quirogaluistomas/MDot_Caudal_Proyecto_2/Capturas de pantalla/Arquitectura1.JPG

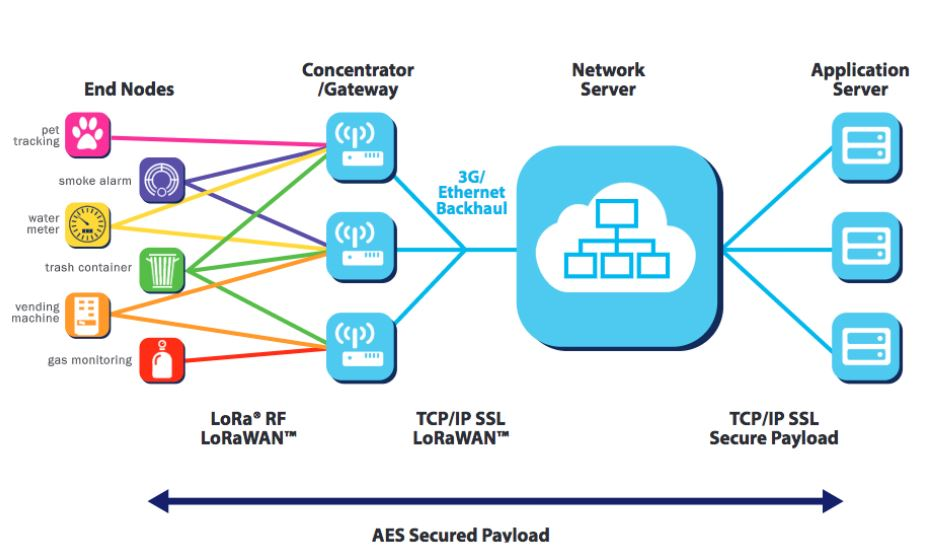
Capturas de pantalla/Arquitectura1.JPG
