quirogaluistomas/MDot_Caudal_Proyecto_2/Capturas de pantalla/Arquitectura LoRa.jpg

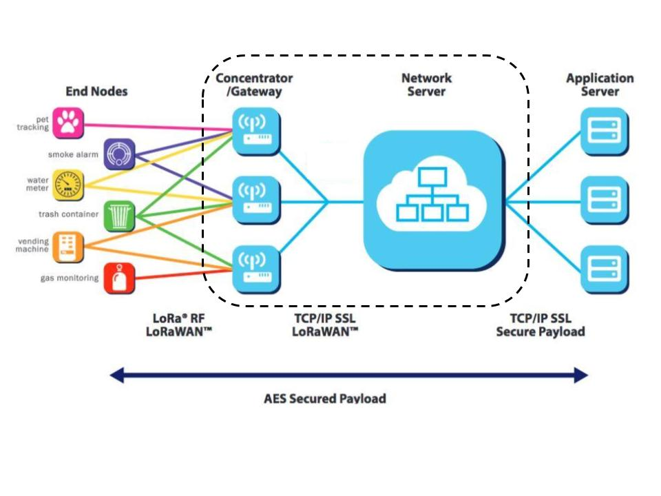
Capturas de pantalla/Arquitectura LoRa.jpg
