quirogaluistomas/MDot_Caudal_Proyecto_2/Capturas de pantalla/Arquitecura2.JPG

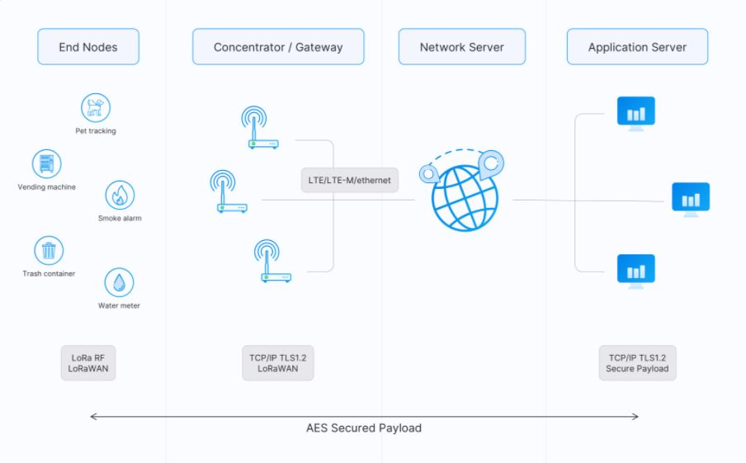
Capturas de pantalla/Arquitecura2.JPG
