quirogaluistomas/MDot_Caudal_Proyecto_2/Capturas de pantalla/Bloques3_GW.JPG

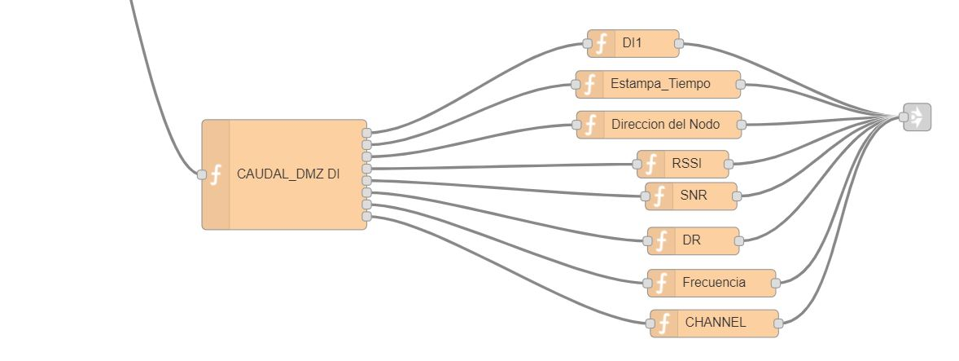
Capturas de pantalla/Bloques3_GW.JPG
