quirogaluistomas/MDot_Caudal_Proyecto_2/Capturas de pantalla/Broker2.JPG

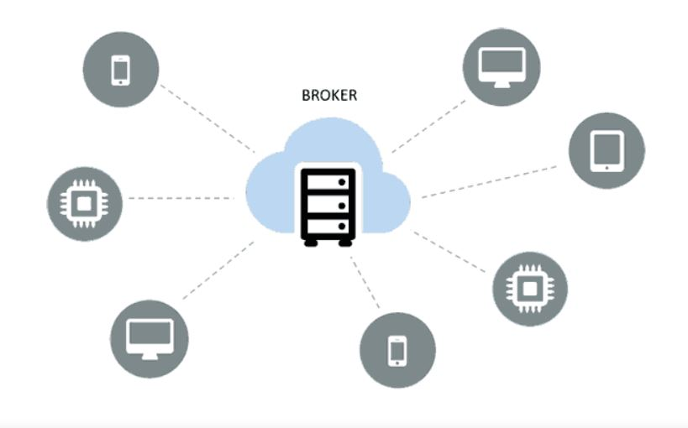
Capturas de pantalla/Broker2.JPG
