quirogaluistomas/MDot_Caudal_Proyecto_2/Capturas de pantalla/Broker.JPG

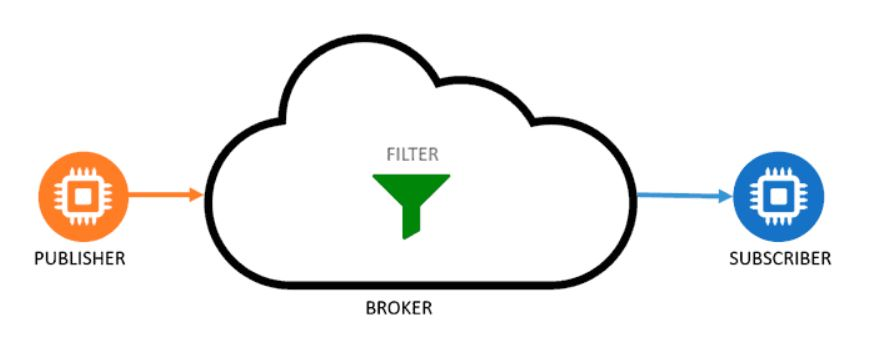
Capturas de pantalla/Broker.JPG
