quirogaluistomas/MDot_Caudal_Proyecto_2/Capturas de pantalla/Clase A.jpg

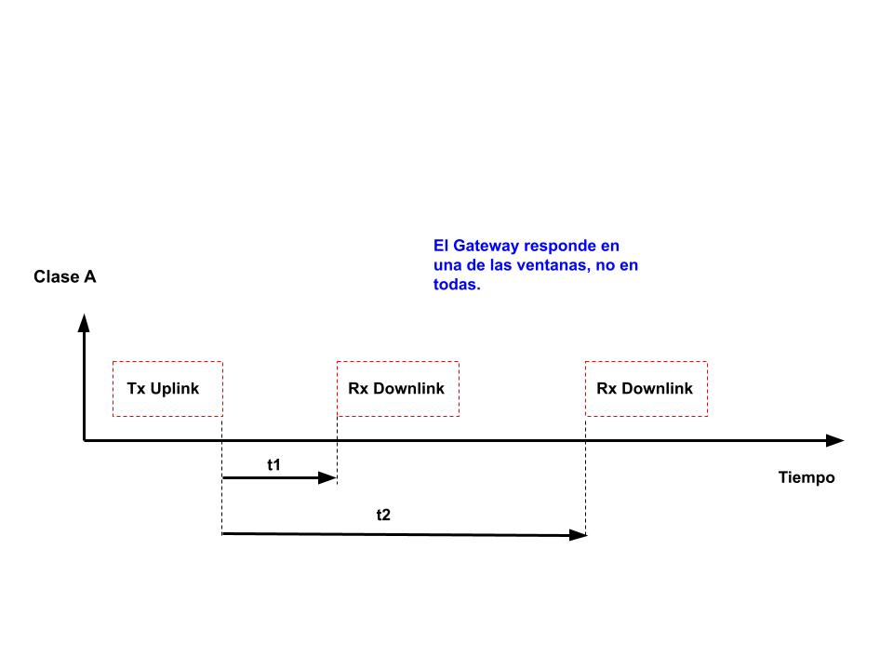
Capturas de pantalla/Clase A.jpg
