quirogaluistomas/MDot_Caudal_Proyecto_2/Capturas de pantalla/Clase B.jpg

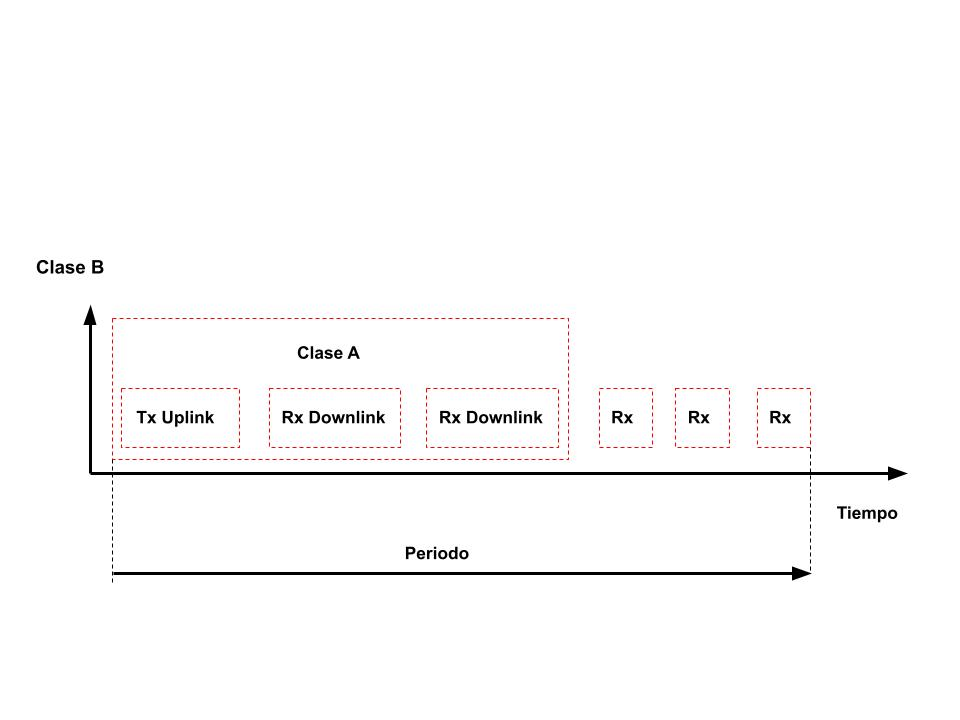
Capturas de pantalla/Clase B.jpg
