quirogaluistomas/MDot_Caudal_Proyecto_2/Capturas de pantalla/Clase C.jpg

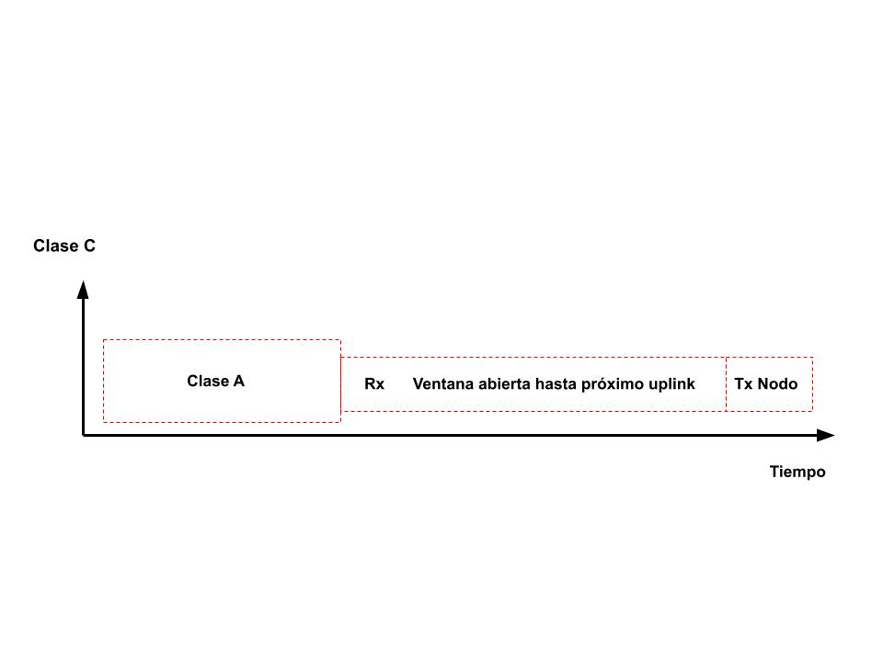
Capturas de pantalla/Clase C.jpg
