quirogaluistomas/MDot_Caudal_Proyecto_2/Capturas de pantalla/DatosCommLoRa.JPG

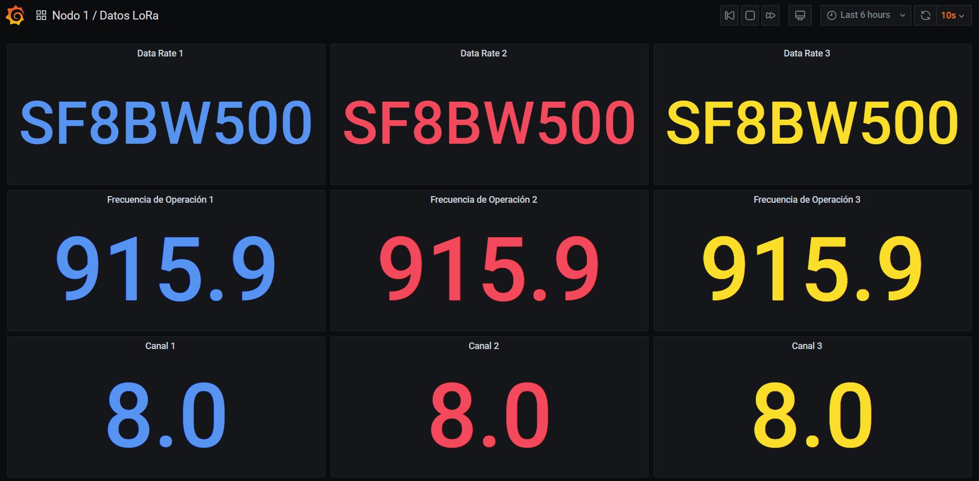
Capturas de pantalla/DatosCommLoRa.JPG
