quirogaluistomas/MDot_Caudal_Proyecto_2/Capturas de pantalla/DatosCommPaquete1_Inicio.JPG

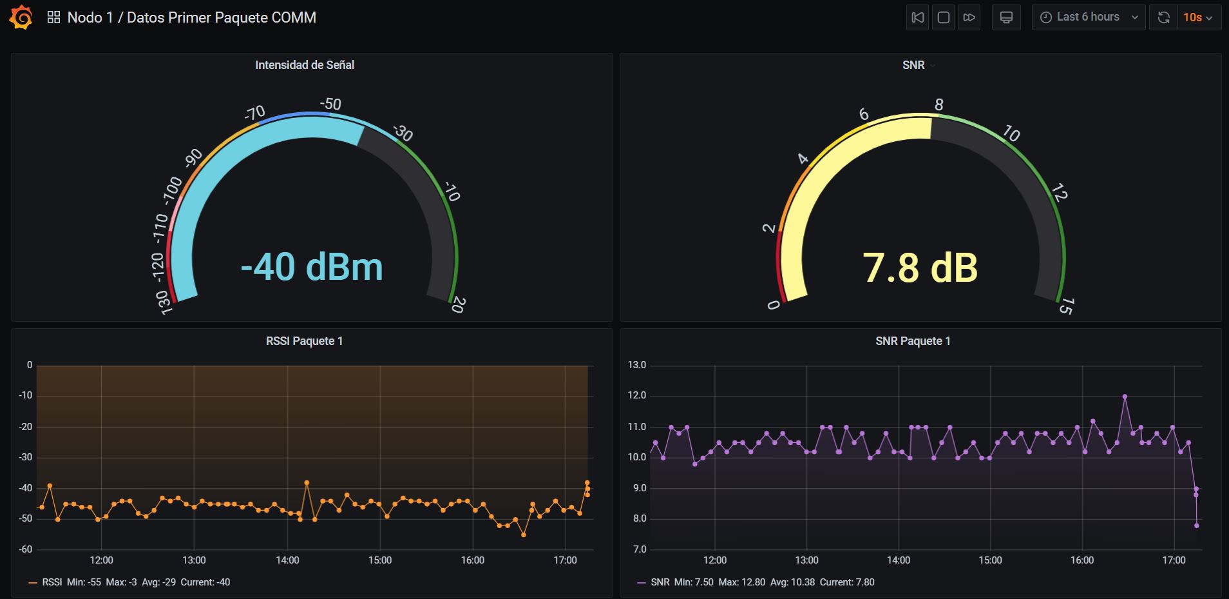
Capturas de pantalla/DatosCommPaquete1_Inicio.JPG
