quirogaluistomas/MDot_Caudal_Proyecto_2/Capturas de pantalla/DatosCommPaquete3.JPG

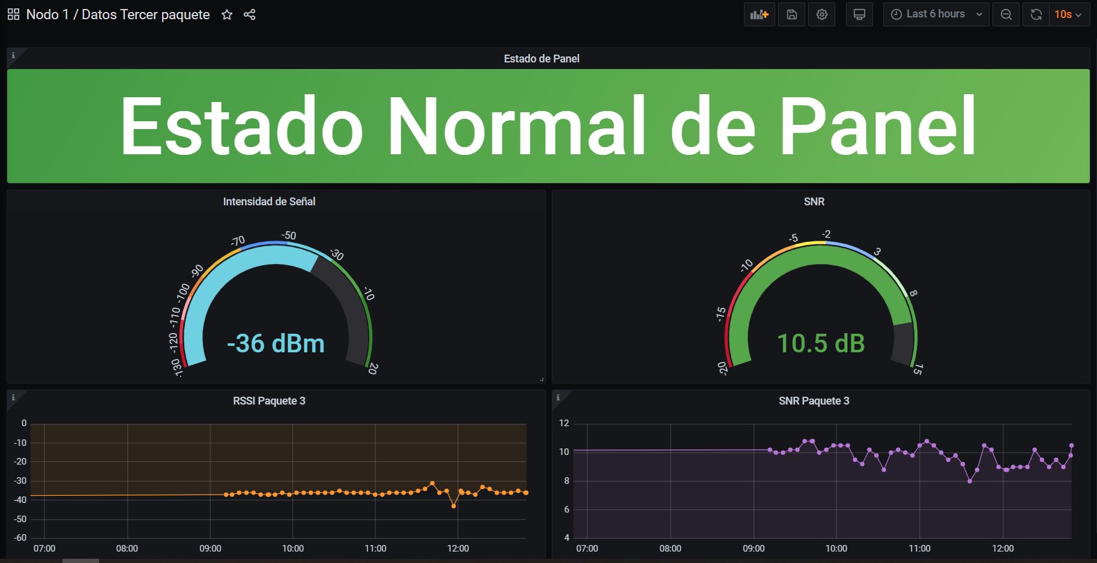
Capturas de pantalla/DatosCommPaquete3.JPG
