quirogaluistomas/MDot_Caudal_Proyecto_2/Capturas de pantalla/DatosCommPaquete3_inicio.JPG

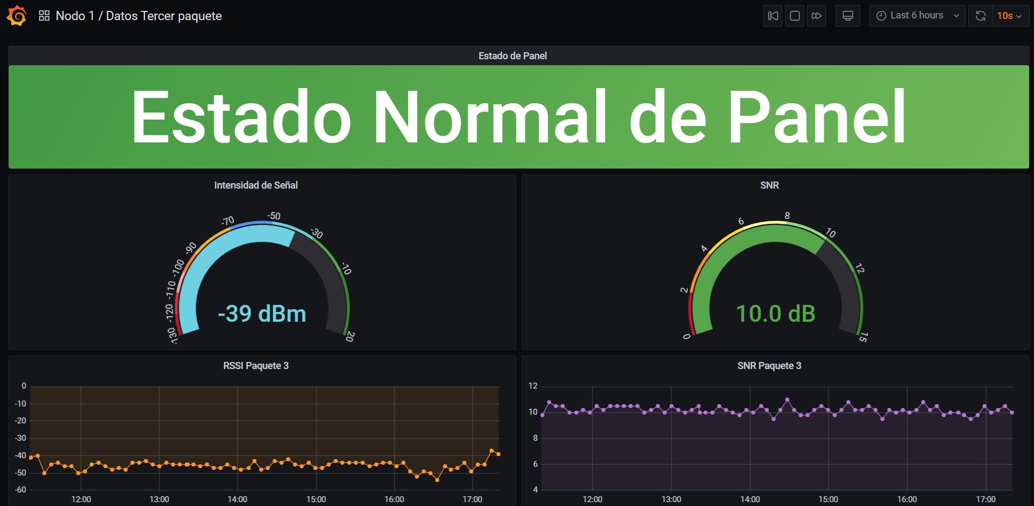
Capturas de pantalla/DatosCommPaquete3_inicio.JPG
