quirogaluistomas/MDot_Caudal_Proyecto_2/Capturas de pantalla/Downlink.JPG

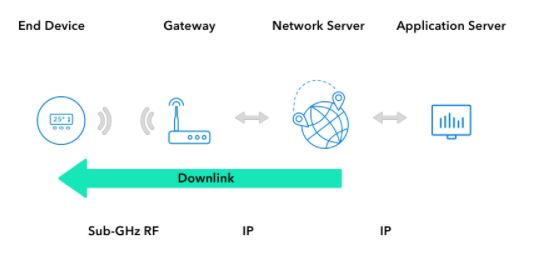
Capturas de pantalla/Downlink.JPG
