quirogaluistomas/MDot_Caudal_Proyecto_2/Capturas de pantalla/Esquema_Integrado.JPG

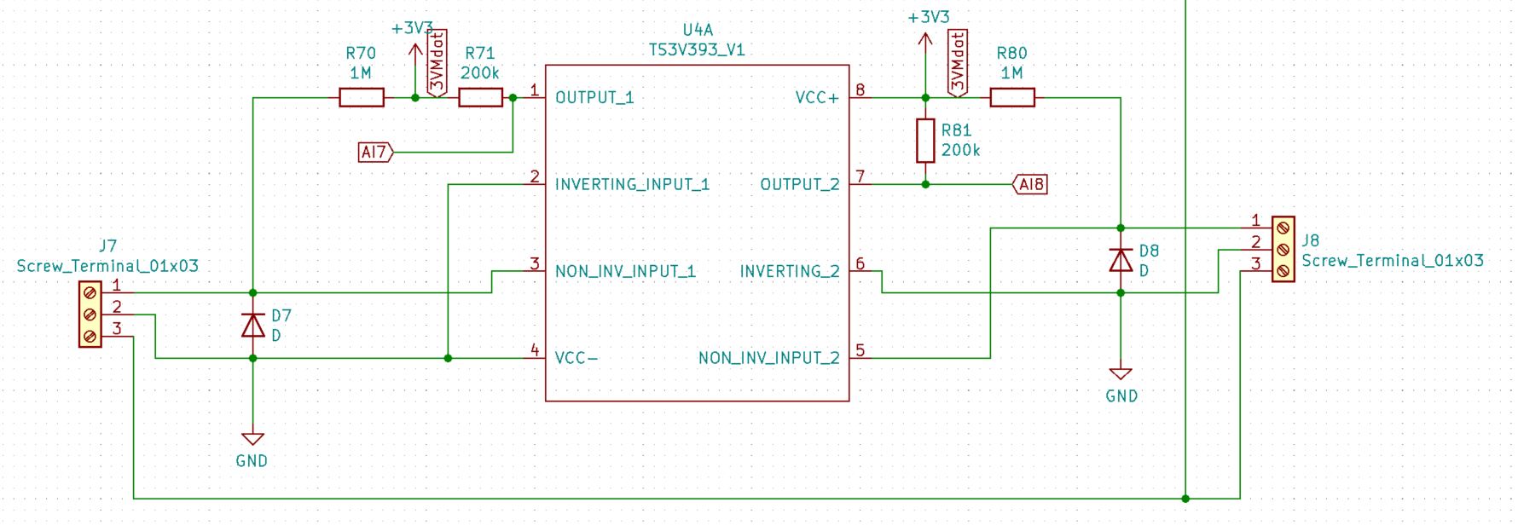
Capturas de pantalla/Esquema_Integrado.JPG
