quirogaluistomas/MDot_Caudal_Proyecto_2/Capturas de pantalla/Esquema_Integrado_OPAMP.JPG

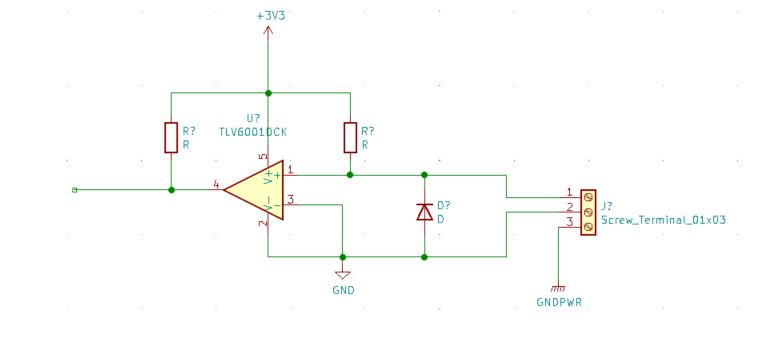
Capturas de pantalla/Esquema_Integrado_OPAMP.JPG
