quirogaluistomas/MDot_Caudal_Proyecto_2/Capturas de pantalla/Esquema_Micro.JPG

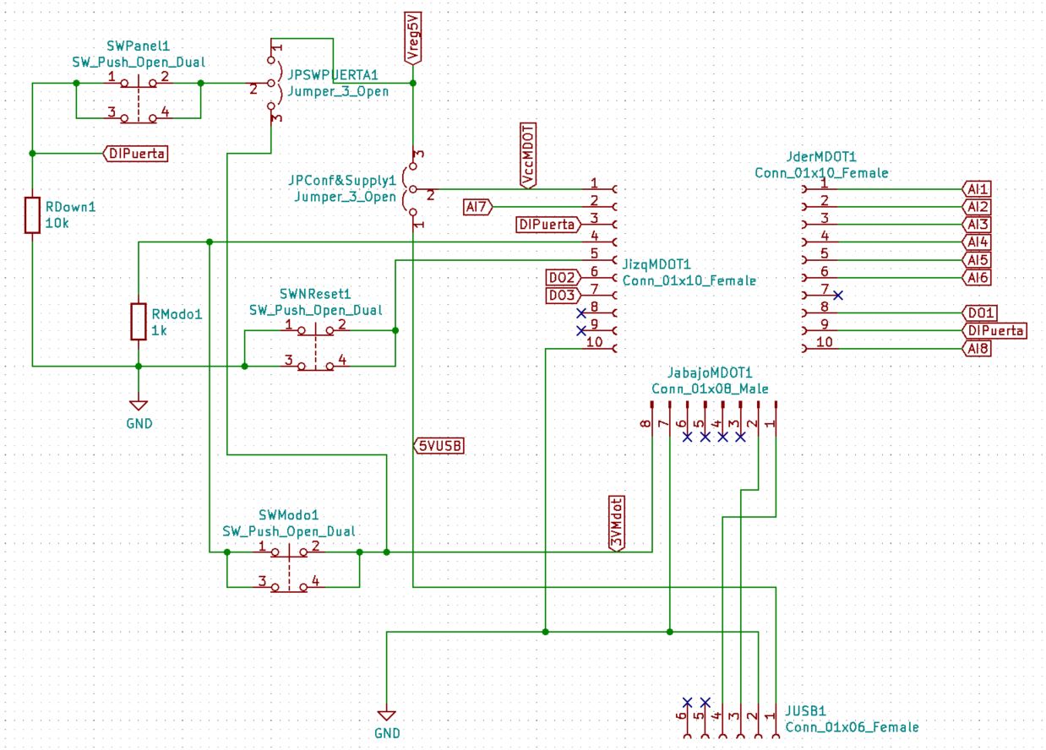
Capturas de pantalla/Esquema_Micro.JPG
