quirogaluistomas/MDot_Caudal_Proyecto_2/Capturas de pantalla/Esquematico_Panel.JPG

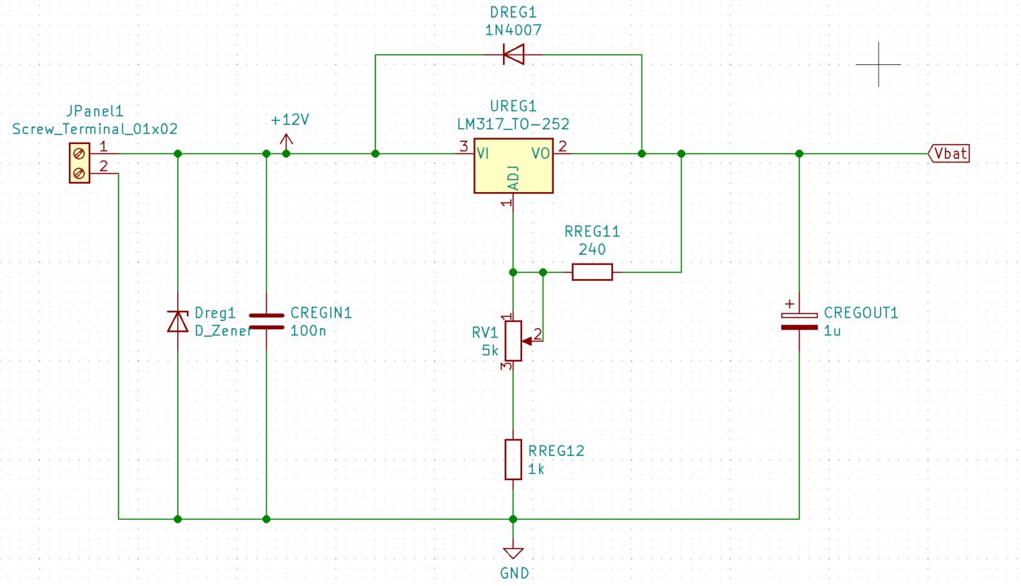
Capturas de pantalla/Esquematico_Panel.JPG
