quirogaluistomas/MDot_Caudal_Proyecto_2/Capturas de pantalla/LoRa Distancia.jpg

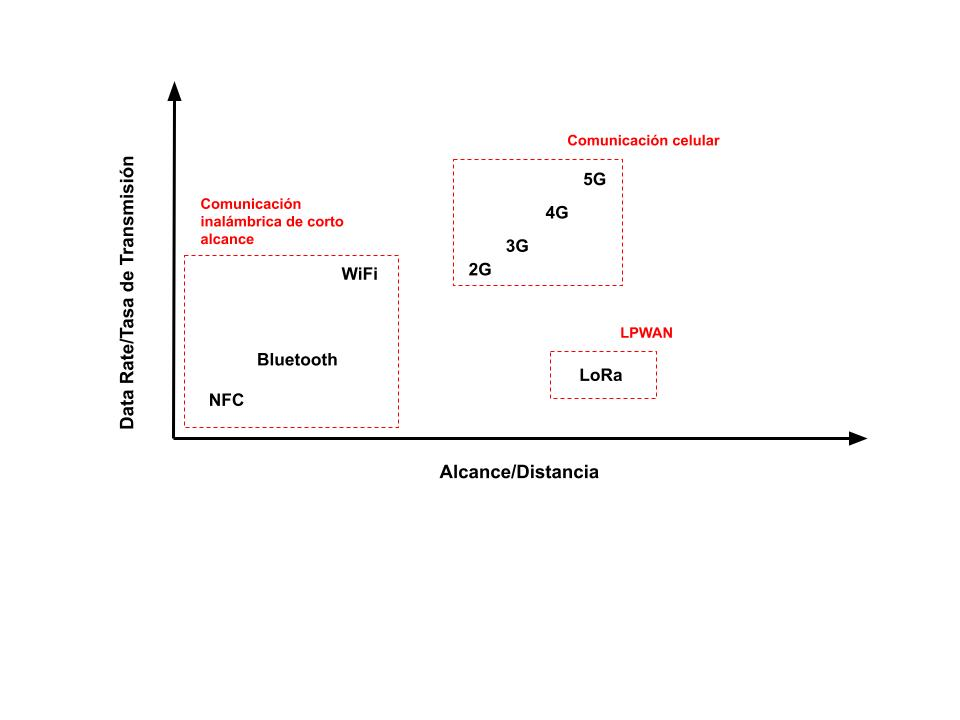
Capturas de pantalla/LoRa Distancia.jpg
