quirogaluistomas/MDot_Caudal_Proyecto_2/Capturas de pantalla/mdot.JPG

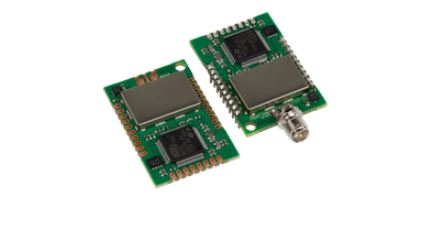
Capturas de pantalla/mdot.JPG
