quirogaluistomas/MDot_Caudal_Proyecto_2/Capturas de pantalla/mDot_pinout.JPG

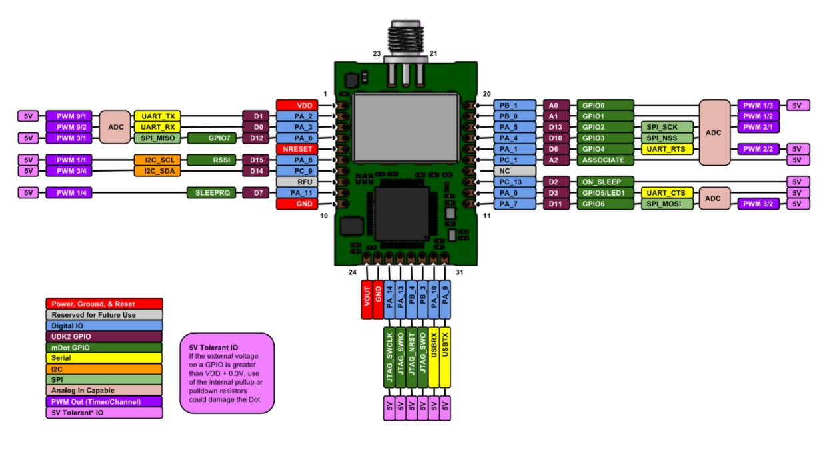
Capturas de pantalla/mDot_pinout.JPG
