quirogaluistomas/MDot_Caudal_Proyecto_2/Capturas de pantalla/NodeRED_GW_Config_Fun_Caudal1.JPG

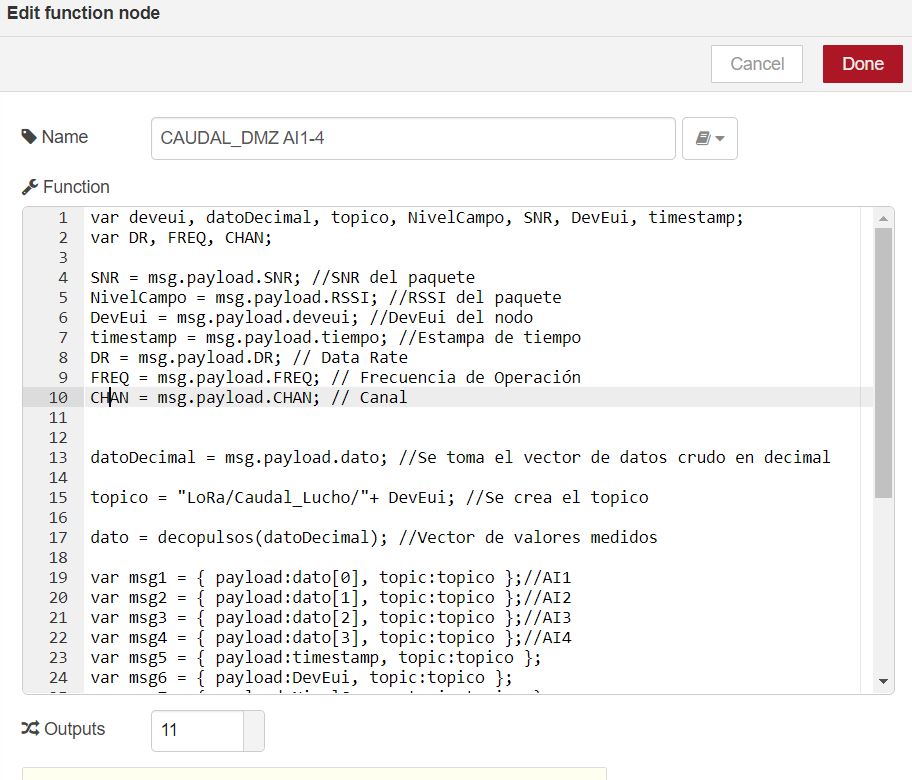
Capturas de pantalla/NodeRED_GW_Config_Fun_Caudal1.JPG
