quirogaluistomas/MDot_Caudal_Proyecto_2/Capturas de pantalla/NodeRED_GW_msg_datopublicado.JPG

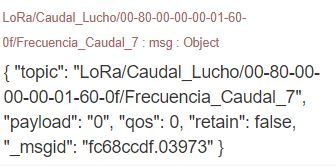
Capturas de pantalla/NodeRED_GW_msg_datopublicado.JPG
