quirogaluistomas/MDot_Caudal_Proyecto_2/Capturas de pantalla/NodeRED_Local_Bloques.JPG

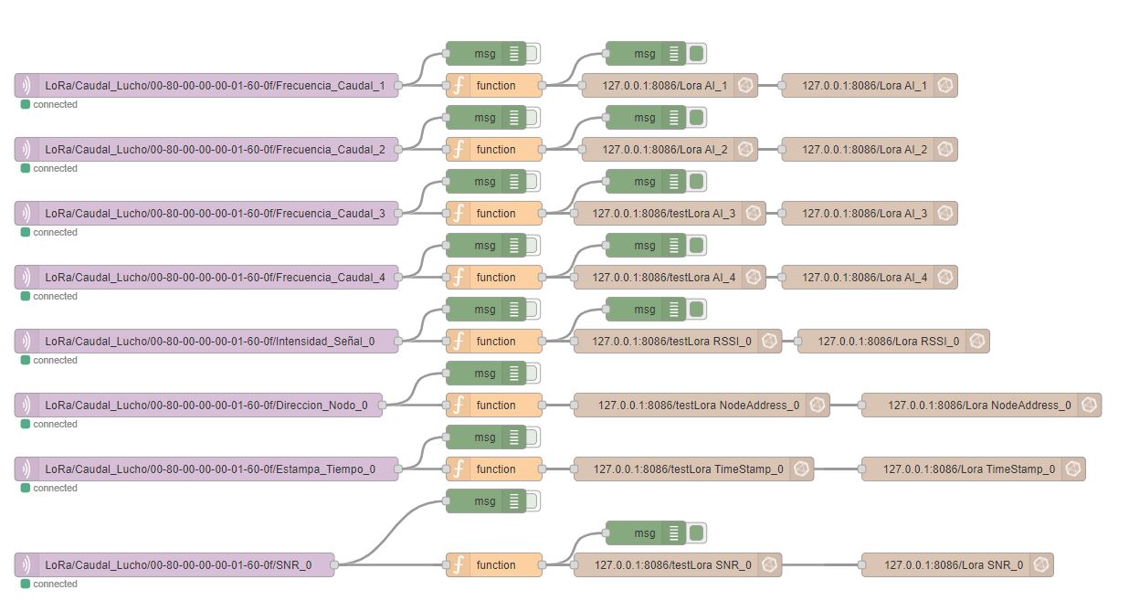
Capturas de pantalla/NodeRED_Local_Bloques.JPG
