quirogaluistomas/MDot_Caudal_Proyecto_2/Capturas de pantalla/NodeRED_Local_Config_MQTT.JPG

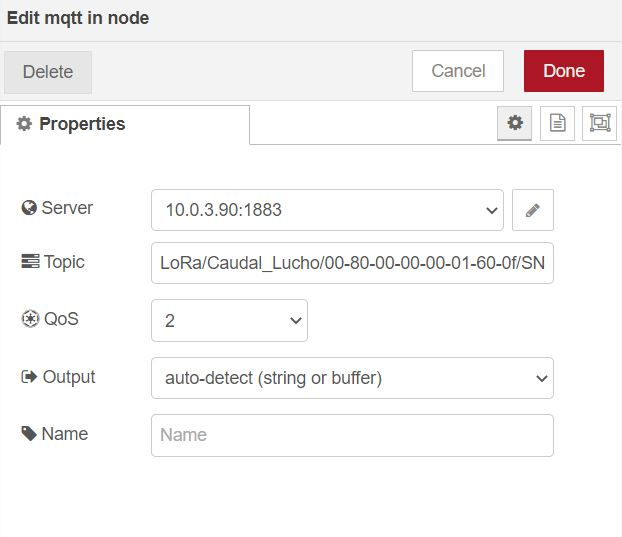
Capturas de pantalla/NodeRED_Local_Config_MQTT.JPG
