quirogaluistomas/MDot_Caudal_Proyecto_2/Capturas de pantalla/PCB_3D.JPG

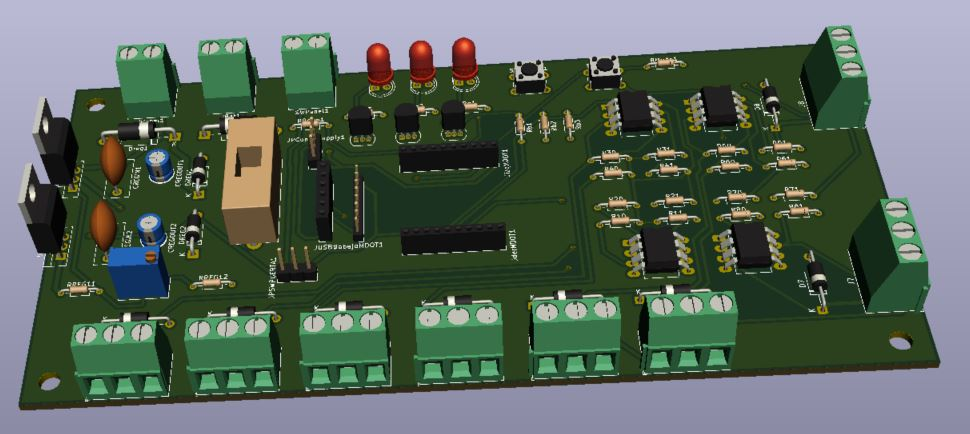
Capturas de pantalla/PCB_3D.JPG
