quirogaluistomas/MDot_Caudal_Proyecto_2/Capturas de pantalla/PCB_3D_1.JPG

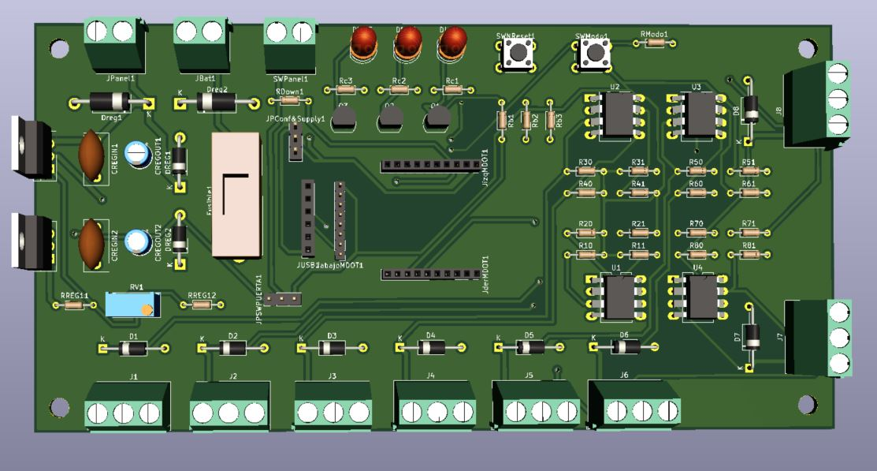
Capturas de pantalla/PCB_3D_1.JPG
