quirogaluistomas/MDot_Caudal_Proyecto_2/Capturas de pantalla/PCB_Back.JPG

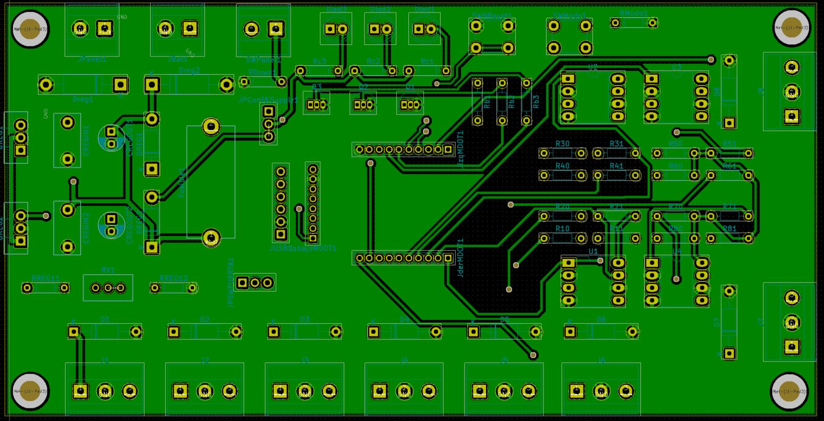
Capturas de pantalla/PCB_Back.JPG
