quirogaluistomas/MDot_Caudal_Proyecto_2/Capturas de pantalla/Sub_bandas_Canales.JPG

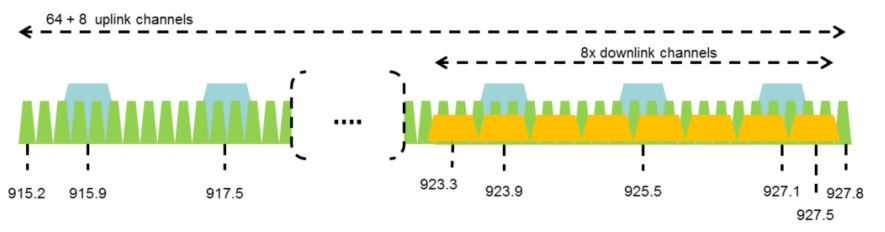
Capturas de pantalla/Sub_bandas_Canales.JPG
