quirogaluistomas/MDot_Caudal_Proyecto_2/Capturas de pantalla/Subbandas.JPG

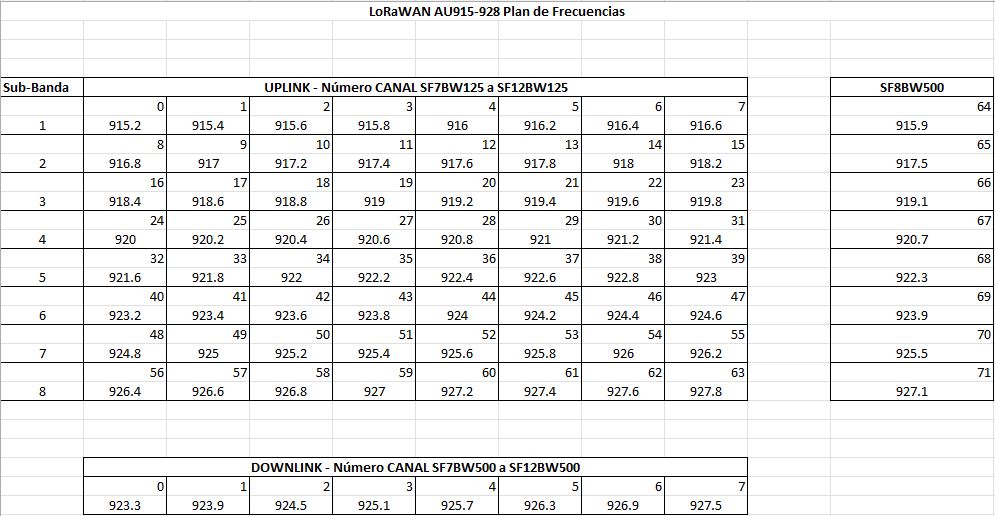
Capturas de pantalla/Subbandas.JPG
