quirogaluistomas/MDot_Caudal_Proyecto_2/Capturas de pantalla/Topics.JPG

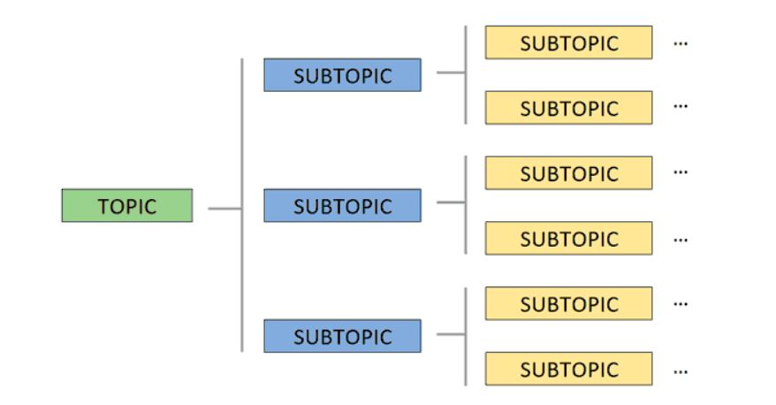
Capturas de pantalla/Topics.JPG
