quirogaluistomas/MDot_Caudal_Proyecto_2/Capturas de pantalla/Uplink.JPG

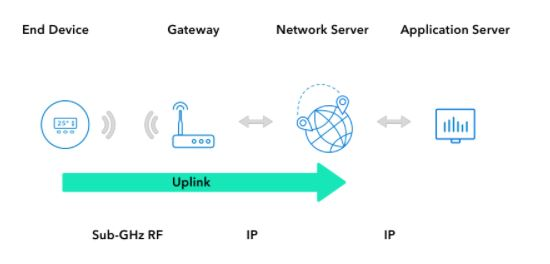
Capturas de pantalla/Uplink.JPG
