quirogaluistomas/MDot_Caudal_Proyecto_2/Listado Materiales Medidor Caudal LoRaWAN.xlsx

Sheet: Armado Placa
Materiales | Detalle | Cantidad | Proveedor | Costo Unitario (USD) | IVA | Costo parcial (USD) | Costo 8 ch (USD) | Estado
mDot | MTDOT-915-AU-X1P-SMA-1 | 1 | Multitech | 32 | 0.21 | 38.72 | 38.72
Resistencias R2 | Valor 1M 1% 1/4 W | 8 | SYC | 0.025 | 0.21 | 0.03025 | 0.242
Resistencias R3 | Valor 220K 1% 1/4 W | 8 | SYC | 0.025 | 0.21 | 0.03025 | 0.242
Resistencias R4 | Valor 220 1% 1/4 W | 4 | SYC | 0.025 | 0.21 | 0.03025 | 0.121 |  | Este reemplaza a la resistencia de 240 del 317.
Resistencias R5 | Valor 1K 1% 1/4 W | 2 | SYC | 0.025 | 0.21 | 0.03025 | 0.0605
Resistencia R6 | Valor 56k 1% 1/4 W | 3 | SYC | 0.025 | 0.21 | 0.03025 | 0.09075
Preset vertical | Valor 5K - 3296x | 1 | SYC | 0.5 | 0.21 | 0.605 | 0.605
Capacitor Cerámico Disco C1 | 100nF | 1 | Microelectronica | 0.03 | 0.21 | 0.0363 | 0.0363
Capacitor Multicapa C5 | 330nF | 1 | Microelectronica | 0.03 | 0.21 | 0.0363 | 0.0363 |  | Este reemplaza al de de 470nF ceramico.
Capacitor Electrolitico 35V C2 | 22uF | 1 | Microelectronica | 0.05 | 0.21 | 0.0605 | 0.0605
Capacitor Electrolitico 100V C4 | 0.47uF | 1 | Microelectronica | 0.04 | 0.21 | 0.0484 | 0.0484 |  | Este en realidad se reemplaza por el de 1uF.
Tira de Pines Hembra p/ USB x 10 | 2,54 mm pitch | 1 | Cicem SRL | 0.13 | 0.21 | 0.1573 | 0.1573
Tira de Pines Macho p/ JMP x 20 | 2,54 mm pitch | 1 | Cicem SRL | 0.13 | 0.21 | 0.1573 | 0.1573
Tira de Pines Macho p/ PCB x 10 | 2 mm pitch | 1 | Microelectronica | 0.474 | 0.21 | 0.57354 | 0.57354
Tira de Pines Hembra p/ PCB x 10 | 2 mm pitch | 2 | Microelectronica | 0.474 | 0.105 | 0.52377 | 1.04754
Comparador Ultra bajo consumo | TS3v3 | 4 | Cicem SRL | 0.84 | 0.105 | 0.9282 | 3.7128
Diodo | 1n4007 | 2 | SYC | 0.025 | 0.105 | 0.027625 | 0.05525
Diodo Schottky | SYC 1N5817 | 8 | SYC | 0.09 | 0.105 | 0.09945 | 0.7956
Diodo Zener 20V | 1N5357 20V 1W | 1 | Microelectronica | 0.121 | 0.105 | 0.133705 | 0.133705
Jumper largo con cola | pitch 2,54 mm | 2 | Microelectronica | 0.072 | 0.21 | 0.08712 | 0.17424
Push Button | Tact switch 4.3 mm | 2 | SYC | 0.08 | 0.105 | 0.0884 | 0.1768
Transistor | BC337 | 3 | SYC | 0.05 | 0.105 | 0.05525 | 0.16575
Led Amarillo | 5 mm | 1 | Microelectronica | 0.0894 | 0.105 | 0.098787 | 0.098787
Led Verde | 5 mm | 1 | Microelectronica | 0.0726 | 0.105 | 0.080223 | 0.080223
Led Rojo | 5 mm | 1 | Microelectronica | 0.0552 | 0.105 | 0.060996 | 0.060996
Regulador Voltaje | LM317T | 1 | SYC | 0.4 | 0.105 | 0.442 | 0.442
Regulador Voltaje 5V | LM2940 | 1 | SYC | 1.6 | 0.105 | 1.768 | 1.768
Disipador | para TO-220 | 1 | SYC | 1.1 | 0.21 | 1.331 | 1.331
Borneras 3 vias a 90 para PCB | Hembra | 8 | SYC | 0.57 | 0.105 | 0.62985 | 5.0388
Borneras 2 vias a 90 para PCB | Hembra | 3 | SYC | 0.35 | 0.105 | 0.38675 | 1.16025
Porta Fuse PCB | 20x5 mm | 1 | Microelectronica | 0.46 | 0.21 | 0.5566 | 0.5566
PCB | Impreso doble Faz con TH y Serigrafia | 1 | MEYER | 26.33 | 0.105 | 29.09465 | 29.09465
Total |  |  |  |  |  |  | 87.043881

Sheet: Armado Gabinete
Materiales | Detalle | Unidades | Proveedor | Costo Unitario (USD) | IVA | costo Parcial (USD) | Costo 1 Kit (USD) | Estado
Gabinete estanco Q Energy | bandeja 230X280X140 código 17232814 | 1 | Genrod | 26.85 | 0.21 | 32.4885 | 32.4885
Kit fijacion gabinete Q Energy |  | 1 | Genrod | 4.54 | 0.21 | 5.4934 | 5.4934
Bateria 12v Acido 7Ah |  | 1 | DGA Electronica | 11.6 | 0.21 | 14.036 | 14.036
Soporte Bateria | Soporte aluminio | 1 | Damez | 2 | 0.21 | 2.42 | 2.42
Panel Solar 12V 3W |  | 1 | Solartec | 7.5 | 0.21 | 9.075 | 9.075
Cable para panel | En metros x 0.25 | 1 | Indeca | 0.81 | 0.21 | 0.9801 | 0.9801
Soporte de Panel solar 1cm | Soporte aluminio | 1 | Damez | 2 | 0.21 | 2.42 | 2.42
Pig tail 50cm RP SMA macho invertido a 90° a N Hembra pasachapa + Cable RG58 | 1m | 1 | Indeca | 9.89 | 0.21 | 11.9669 | 11.9669
Antena 900 MHz 3 dbi Omni HG903UP-NF + Soporte | L-com 900 Mhz | 1 | L-Com | 87.26 | 0.21 | 105.5846 | 105.5846
Torres separadoras | Plásticas 15mm | 4 | Microelectronica | 0.638 | 0.21 | 0.77198 | 3.08792
Varios | Cables, termocontraibles, terminales | 1 | Damez | 2 | 0.21 | 2.42 | 2.42
Chapa Identificatoria | 8x4 | 1 | Damez | 1.2 | 0.21 | 1.452 | 1.452
Total |  |  |  |  |  |  | 191.42442
Tarea | Detalle | Horas |  | Precio Unitario USD | Precio Total USD
Horas Armado RTU y pruebas | Conforme a Ingeniería | 6 |  | 9.42 | 56.52

Sheet: Montaje
Materiales | Detalle | Unidades | Proveedor | Costo Unitario (USD) | IVA | costo Parcial (USD) | Costo 1 Kit (USD) | Estado
Prensacaño para caja rectangular | 1/2" NPT RECTO | 8 | Jumaled | 2.2 | 0.21 | 2.662 | 21.296
Prensacaño para caja de paso redonda | 3/4" NPT RECTO | 8 | Jumaled | 2.96 | 0.21 | 3.5816 | 28.6528
Caja paso rectangular a rosca | 1/2" | 8 | Jumaled | 3.61 | 0.21 | 4.3681 | 34.9448
Caja paso redonda de paso o empalme | 3/4" | 8 | Jumaled | 8.6 | 0.21 | 10.406 | 83.248
Broca SDS de anclaje de expansión p/anclaje en hormigón | 1/2" | 4 | Jumaled | 1.04 | 0.21 | 1.2584 | 5.0336
Bulon de acero | 1/2 x 3/4 | 4 | Jumaled | 0.23 | 0.21 | 0.2783 | 1.1132
Arandela plana | 3/4" | 4 | Jumaled | 0.32 | 0.21 | 0.3872 | 1.5488
Prensable recto | 1/2" | 16 | Jumaled | 0.35 | 0.21 | 0.4235 | 6.776
Cable mallado para señales | 2x0.5mm | 16 | Jumaled | 0.82 | 0.21 | 0.9922 | 15.8752
Tubo termocontraible | En metros | 2 | Jumaled | 0.38 | 0.21 | 0.4598 | 0.9196
Caño flexible corrugado | 3/4" | 10 | Jumaled | 3.45 | 0.21 | 4.1745 | 41.745
Caño flexible corrugado | 1/2" | 16 | Jumaled | 2.46 | 0.21 | 2.9766 | 47.6256
Tuerca luz 1/2" p/ caja redonda | NPT nodular | 1 | Jumaled | 0.34 | 0.21 | 0.4114 | 0.4114
Tuerca luz 3/4" p/ caja redonda | NPT nodular | 1 | Jumaled | 0.55 | 0.21 | 0.6655 | 0.6655
Caño hierro negro 3"x 2mts y tapa superior caño espesor 2,1mm | Kg | 5.75 | Casa Manito | 2.25 | 0.21 | 2.7225 | 15.654375
Electrodos 2.5mm Punta azul | Por kg | 1 | Dal Poggetto e Hijos | 4.56 | 0.21 | 5.5176 | 5.5176
Escuadra | 10x10x1/4" | 4 | HIMAQ | 1.41 | 0.21 | 1.7061 | 6.8244
Planchuela cuadrada de hierro para base | 30x30x1/4" | 1 | HIMAQ | 11.04 | 0.21 | 13.3584 | 13.3584
Varilla roscada galvanizada | 1/2" | 2 | Casa Manito | 3.84 | 0.21 | 4.6464 | 9.2928
Pintura Epoxi Negro | Por litro | 0.5 | Rex | 31.2 | 0.21 | 37.752 | 18.876
Diluyente Epoxi | Por litro | 0.5 | Rex | 18 | 0.21 | 21.78 | 10.89
Precintos metálicos | 500x25 | 16 |  | 0.71 | 0.21 | 0.8591 | 13.7456
Total |  |  |  |  |  |  | 370.269075
Tarea | Detalle | Horas |  | Precio Unitario USD | Precio Total USD
Horas de soldado y armado de mastil | Conforme a Ingeniería | 16 |  | 9.42 | 150.72

Sheet: Inv.Sueldos
INVERSION DE CAPITAL EN ESTUDIO Y DESARROLLO
 |  |  |  |  |  |  |  | Antes de la línea
MES | Encargado de Stock (1) | Equipo de Venta (1) | Equipo de Ingeniería/ Jefe de Proyecto (1) | Equipo de Desarrollo (1) | Técnico de Ensamblado (1) | COSTOS TOTALES
1 | 0.00 | 154.00 | 795.31 | 320.32 | 0.00 | 1269.63 | Marzo |  | Lucho | 7.28 | 1164
2 | 0.00 | 0.00 | 1406.99 | 800.80 | 0.00 | 2207.79 | Abril |  | Damian | 10.27 | 1643
3 | 0.00 | 231.00 | 1637.04 | 611.52 | 0.00 | 2479.56 | Mayo |  | Adrián | 7.7 | 1232
4 | 0.00 | 338.80 | 1129.70 | 232.96 | 0.00 | 1701.46 | Junio |  | Pablo | 5.99 | 958.4
5 | 0.00 | 431.20 | 1139.97 | 524.16 | 0.00 | 2095.33 | Julio |  | Marcelo | 9.42 | 1507.2
6 | 0.00 | 0.00 | 410.80 | 611.52 | 0.00 | 1022.32 | Agosto
7 | 0.00 | 0.00 | 400.53 | 844.48 | 0.00 | 1245.01 | Septiembre
8 | 47.92 | 63.14 | 872.95 | 946.40 | 0.00 | 1930.41 | Octubre
9 | 203.66 | 130.90 | 1386.45 | 669.76 | 0.00 | 2390.77 | Noviembre
10 | 323.46 | 154.00 | 1109.16 | 902.72 | 0.00 | 2489.34 | Diciembre
11 | 299.50 | 0.00 | 534.04 | 771.68 | 0.00 | 1605.22 | Enero
12 | 215.64 | 46.20 | 626.47 | 582.40 | 188.40 | 1659.11 | Febrero
13 | 383.36 | 30.80 | 759.98 | 626.08 | 226.08 | 2026.30 | Marzo
14 | 103.03 | 0.00 | 790.79 | 378.56 | 0.00 | 1272.38 | Abril
15 | 0.00 | 0.00 | 718.90 | 626.08 | 0.00 | 1344.98 | Mayo
16 | 0.00 | 0.00 | 718.90 | 728.00 | 0.00 | 1446.90 | Junio
17 | 0.00 | 0.00 | 534.04 | 305.76 | 0.00 | 839.80 | Julio
18 | 0.00 | 0.00 | 492.96 | 276.64 | 0.00 | 769.60 | Agosto
19 | 0.00 | 0.00 | 308.10 | 101.92 | 565.20 | 975.22 | Septiembre
20 |  |  |  |  |  | 0.00 | Octubre
21 | 1576.57 | 1580.04 | 15773.08 | 10861.76 | 979.68 | 30771.13
22
23
24
25 | PRIMER SEMESTRE
26 | 0.00 | 1155.00 | 6519.81 | 3101.28 | 0.00 | 10776.09
27
28 | SEGUNDO SEMESTRE
29 | 1090.18 | 394.24 | 4929.60 | 4717.44 | 188.40 | 11319.86
30
31 | TERCER SEMESTRE
32 | 486.39 | 30.80 | 4015.57 | 2941.12 | 226.08 | 7699.96
33
34 | CUARTO SEMESTRE
35 | 0.00 | 0.00 | 308.10 | 101.92 | 565.20 | 975.22
36
37
38
39
40
41
42
43
44
45
46
47
48
49
50
51
52
53
54
55
56
57
58
59
60
TOTAL

Sheet: Inv.Materiales
MATERIALES DE INVERSIÓN PARA DESARROLLO Y PRUEBAS
 |  |  | Antes de la línea
Para pruebas y repetibilidad
Placas | 346.846155 | Acá se compran materiales para 5 kits pero con PCB clásico
Gabinete | 957.1221 | Acá se compran materiales para 5 kits pero solo se arma 1
 |  |  |  | Lucho | 7.28
Total | 1303.968255 |  |  | Damian | 10.27
 |  |  |  | Adrián | 7.7
 |  |  |  | Pablo | 5.99
 |  |  |  | Marcelo | 9.42
Prototipo p/ prueba en sitio
Soldado de placa | 102.7 | Se sueldan y se prueban los componentes del prototipo
Construcción de Gabinete | 56.52 | Se construye solo 1 para prueba en sitio de clientes
 |  | Solo se envía gabinete, panel, antena y bateria. Del resto, lo que falta, se encargaron ellos. Se consideró minimo 15kg
Leandro PM | 82.16
Total | 241.38
Definitivos
Placas | 435.219405 | 5 Placas definitivas para repetibilidad y pruebas
Soldado de placas | 291.2 | Se sueldan las 5 placas para ensayos
Total | 726.419405

Sheet: Inv.Materiales p Stock
Inversión para stock de ventas
 |  |  | Luego de la línea
Placas p/ stock de ventas | 1305.658215 | 15 unidades
Placas para repetibilidad | 174.087762 | 2 unidades
Gabinete p/ stock de ventas | 2871.3663 | 15 unidades
Gabinete para repetibilidad | 382.84884 | 2 Unidades
Mástil p/ stock de ventas | 5554.036125 | 15 Unidades
Total p/stock | 10287.99724

Sheet: Consideraciones Costos
Concepto | Costo (USD) | Tiempo asignado a la tarea | Conceptos de Gastos/Costos
Flete de gabinetes + caños para montaje | 1.05 + 0.8% Seguro declarado | Por kg aunque también es función del volumen. Precio minimo 15kg | Gastos Generales
Embalaje (1 persona) | 5.14 | 1h/kit (Sueldo 60 Neto) | Gastos Generales
Vuelo a sitio para puesta en marcha (2 personas) | 257.14 |  | Gastos Generales
Dia viajado (2 personas) | 15.23 |  | MOD
Transporte a yacimiento para instalación Camioneta | 21.25 | (Medio tanque por sitio) 0.85usd x litro de gasoil | MOD
Logísitca de Sector Venta | 7.7 | 2h/total | MOI
Instalación y PM (2 personas) | 10.27 + 9.42 | 6h/sitio | MOD
Soporte de Oficina en PM | 7.28 | 1h/sitio | MOI
Construcción de Mastil | 9.42 | 16h x mastil | MOD
MOD = Mano de Obra Directa
MOI = Mano de Obra Indirecta

Sheet: Resumen
PROYECTO: | LORAWAN CAUDAL
Fecha: | 2021-12-17
PARÁMETROS GLOBALES
Precio de Venta: |  | 2000
 |  |  |  | Tasa mensual USD | 0.146%
 |  |  | VAN AJUST | TIR AJUST
UTILIDAD TEÓRICA: |  | 273687.72 | 269217.43 | 23.03%
PERIODO 6 MESES | UNIDADES A VENDER | INVERSION SUELDOS | INVERSION MATERIALES | COSTOS VARIABLES | VENTAS | IIBB | EGRESOS | IMP. GAN. | INGRESOS ACUMULADOS | EGRESOS ACUMULADOS | ING-EGRESOS | (1+i)^n | PERÍODOS | ING AJUST | EGR AJUST | ING ACUM AJ | EGR ACUM AJ | I-E AJUST
1 |  | 10776.09 | 1303.97 | 0.00 | 0.00 | 0.00 | 12080.06 |  | 0.00 | 12080.06 | -12080.06 | 1.00000 | 0 | 0.00 | 12080.06 | 0.00 | 12080.06 | -12080.06
2 |  | 11319.86 | 241.38 | 0.00 | 0.00 | 0.00 | 11561.24 |  | 0.00 | 23641.30 | -23641.30 | 1.00146 | 1 | 0.00 | 11544.41 | 0.00 | 23624.46 | -23624.46
3 |  | 7699.96 | 726.42 | 0.00 | 0.00 | 0.00 | 8426.38 |  | 0.00 | 32067.67 | -32067.67 | 1.00292 | 2 | 0.00 | 8401.86 | 0.00 | 32026.32 | -32026.32
4 |  | 975.22 | 10288.00 | 0.00 | 0.00 | 0.00 | 11263.22 |  | 0.00 | 43330.89 | -43330.89 | 1.00438 | 3 | 0.00 | 11214.10 | 0.00 | 43240.42 | -43240.42
5 | 40 |  |  | 35369.50 | 0.00 | 0.00 | 35369.50 |  | 0.00 | 78700.39 | -78700.39 | 1.00584 | 4 | 0.00 | 35163.97 | 0.00 | 78404.39 | -78404.39
6 | 50 |  |  | 44211.87 | 80000.00 | 2400.00 | 46611.87 |  | 80000.00 | 125312.25 | -45312.25 | 1.00731 | 5 | 79419.34 | 46273.55 | 79419.34 | 124677.94 | -45258.60
7 | 60 |  |  | 53054.24 | 100000.00 | 3000.00 | 56054.24 | 27066.86 | 180000.00 | 208433.36 | -28433.36 | 1.00878 | 6 | 99129.65 | 82397.66 | 178548.99 | 207075.60 | -28526.61
8 | 60 |  |  | 53054.24 | 120000.00 | 3600.00 | 56654.24 |  | 300000.00 | 265087.60 | 34912.40 | 1.01025 | 7 | 118782.39 | 56079.39 | 297331.38 | 263154.98 | 34176.40
9 | 60 |  |  | 53054.24 | 120000.00 | 3600.00 | 56654.24 | 44342.03 | 420000.00 | 366083.87 | 53916.13 | 1.01172 | 8 | 118609.46 | 99825.94 | 415940.84 | 362980.93 | 52959.91
10 | 50 |  |  | 44211.87 | 120000.00 | 3600.00 | 47811.87 |  | 540000.00 | 413895.74 | 126104.26 | 1.01320 | 9 | 118436.78 | 47189.03 | 534377.62 | 410169.96 | 124207.66
11 | 50 |  |  | 44211.87 | 100000.00 | 3000.00 | 47211.87 | 43741.69 | 640000.00 | 504849.30 | 135150.70 | 1.01468 | 10 | 98553.62 | 89638.03 | 632931.24 | 499807.99 | 133123.25
12 | 40 |  |  | 35369.50 | 100000.00 | 3000.00 | 38369.50 |  | 740000.00 | 543218.80 | 196781.20 | 1.01616 | 11 | 98410.14 | 37759.47 | 731341.38 | 537567.46 | 193773.92
13 | 40 |  |  | 35369.50 | 80000.00 | 2400.00 | 37769.50 | 36351.35 | 820000.00 | 617339.65 | 202660.35 | 1.01764 | 12 | 78613.50 | 72836.24 | 809954.88 | 610403.70 | 199551.18
14 | 30 |  |  | 26527.12 | 80000.00 | 2400.00 | 28927.12 |  | 900000.00 | 646266.77 | 253733.23 | 1.01912 | 13 | 78499.04 | 28384.39 | 888453.92 | 638788.09 | 249665.83
15 |  |  |  |  | 60000.00 | 1800.00 | 1800.00 | 38245.51 | 960000.00 | 686312.28 | 273687.72 | 1.02061 | 14 | 58788.57 | 39236.97 | 947242.49 | 678025.06 | 269217.43
16 |  |  |  |  | 0.00 | 0.00 | 0.00 |  | 960000.00 | 686312.28 | 273687.72 | 1.02209 | 15 | 0.00 | 0.00 | 947242.49 | 678025.06 | 269217.43
TOTALES | 480 | 30771.13 | 12559.76 | 424433.94 | 960000.00 | 28800.00 | 496564.83 | 189747.44
 | a8:96:75:6a:d6:7b
 | a8:a6:68:e3:11:f0

Sheet: Costo de Producto
Costo de producto sin servicio | PM = Puesta en Marcha
Costos MOD, Materiales y Gastos Generales de Producción | Cantidad | Tiempo asignado a la tarea por unidad [Hora] | Costo unidad | Costo Total
Materiales Placas | 1 |  | 87.043881 | 87.043881
Construcción Placas | 1 | 10 | 72.8 | 72.8
Materiales Gabinetes | 1 |  | 191.42442 | 191.42442
Construcción Gabinetes | 1 | 6 | 56.52 | 56.52
Materiales Mástil | 1 |  | 370.269075 | 370.269075
Construcción Mástil | 1 | 8 | 75.36 | 75.36
Embalaje | 1 | 1 | 5.14 | 5.14
Pintura | 1 | 2 | 10.28 | 10.28
Costos MOI para venta de producto
Logística de Sector Ventas | - | 2 | 15.4 | 15.4
 |  | Costo Unidad de Producto | 884.237376 | 884.237376

Sheet: Costo de Producto Con PM
Costo de unidad con servicio de PM. | PM = Puesta en Marcha
Costos MOD, Materiales y Gastos Generales de Producción y PM | Cantidad | Tiempo asignado a la tarea por unidad [Hora] | Costo unidad | Costo Total
Materiales Placas | 1 |  | 87.043881 | 87.043881
Construcción Placas | 1 | 10 | 72.8 | 72.8
Materiales Gabinetes | 1 |  | 191.42442 | 191.42442
Construcción Gabinetes | 1 | 6 | 56.52 | 56.52
Materiales para Montaje | 1 |  | 370.269075 | 370.269075
Construcción Mástil | 1 | 8 | 75.36 | 75.36
Embalaje | 1 | 1 | 5.14 | 5.14
Pintura | 1 | 2 | 10.28 | 10.28
Flete de gabinetes + caños para montaje | 1 | - | 606.538145 | 606.538145
Extra Dia Viajado (2 personas) | 4 | - | - | 60.92
Transporte a yacimiento para instalación Camioneta | 1 | - |  | 21.25
Vuelo a sitio para puesta en marcha (2 personas) | 2 | - | 257.14 | 514.28
Instalación y PM | 1 | 6 | 118.14 | 118.14
 |  | Total MOD | 2189.965521 | 2189.965521
Costos MOI para producción y PM | Cantidad | Tiempo asignado a la tarea por unidad [Hora] | Costo unidad | Costo Total
Soporte de oficina en PM | 1 | 1 | 7.28 | 7.28
Logística de Sector Ventas | - | 2 | 15.4 | 15.4
Gastos promedio de personal en Ciudad | 2 |  | 38.09 | 76.18
 |  | Total MOI |  | 98.86
 |  | Costo de 1 unidad |  | 2288.825521

Sheet: Ejemplo para 10 unidades
Costo de unidad con servicio de PM. | PM = Puesta en Marcha
Costos MOD, Materiales y Gastos Generales de Producción y PM | Cantidad | Tiempo asignado a la tarea por unidad [Hora] | Costo unidad | Costo Total
Materiales Placas | 10 |  | 87.043881 | 870.43881
Construcción Placas | 10 | 10 | 72.8 | 728
Materiales Gabinetes | 10 |  | 191.42442 | 1914.2442
Construcción Gabinetes | 10 | 6 | 56.52 | 565.2
Materiales Mástil | 10 |  | 370.269075 | 3702.69075
Construcción Mástil | 10 | 8 | 75.36 | 753.6
Embalaje | 10 | 1 | 5.14 | 51.4
Pintura | 10 | 2 | 10.28 | 102.8
Flete de gabinetes + caños para montaje | 10 | - | 606.538145 | 5923.63145
Extra Dia Viajado (2 personas) | 24 | - | - | 365.52
Transporte a yacimiento para instalación Camioneta | 10 | - |  | 212.5
Vuelo a sitio para puesta en marcha (2 personas) | 2 | - | 257.14 | 514.28
Instalación y PM | 10 | 6 | 118.14 | 1181.4
 |  | Total MOD | 1688.570521 | 16885.70521
Costos MOI para producción y PM | Cantidad | Tiempo asignado a la tarea por unidad [Hora] | Costo unidad | Costo Total
Soporte de oficina en PM | 10 | 1 | 7.28 | 72.8
Logística de Sector Ventas | - | 2 | 15.4 | 15.4
Gastos promedio de personal en Ciudad | 12 |  | 38.09 | 457.08
 |  | Total MOI | 54.528 | 545.28
 |  | Costo de 1 unidad |  | 17430.98521

Sheet: Impuestos
IMPUESTOS A LAS GANANCIAS
 | Año 1 | Año 2 | Año 3 | Año 4 | Año 5
INGRESOS | 180000.00 | 240000.00 | 220000.00 | 180000.00 | 140000.00
EGRESOS | 102666.11 | 113308.49 | 95023.74 | 76138.99 | 30727.12
I-E | 77333.89 | 126691.51 | 124976.26 | 103861.01 | 109272.88
Impuestos | 27066.86 | 44342.03 | 43741.69 | 36351.35 | 38245.51

Sheet: Otros Ingresos
OTROS INGRESOS
Por ejemplo inversiones del excedente del flujo de fondos
MES | Flujo de fondos | Saldo positivo | Inversión
1 | -12080.06 | 0.00 | 0.00
2 | -23641.30 | 0.00 | 0.00
3 | -32067.67 | 0.00 | 0.00
4 | -43330.89 | 0.00 | 0.00
5 | -78700.39 | 0.00 | 0.00
6 | -45312.25 | 0.00 | 0.00
7 | -28433.36 | 0.00 | 0.00
8 | 34912.40 | 34912.40 | 0.00
9 | 53916.13 | 53916.13 | 0.00
10 | 126104.26 | 126104.26 | 0.00
11 | 135150.70 | 135150.70 | 0.00
12 | 196781.20 | 196781.20 | 0.00
13 | 202660.35 | 202660.35 | 0.00
14 | 253733.23 | 253733.23 | 0.00
15 | #REF! | #REF! | 0.00
16 | #REF! | #REF! | 0.00
17 | #REF! | #REF! | 0.00
18 | #REF! | #REF! | 0.00
19 | #REF! | #REF! | 0.00
20 | #REF! | #REF! | #REF!
21 | #REF! | #REF! | #REF!
22 | #REF! | #REF! | #REF!
23 | #REF! | #REF! | #REF!
24 | #REF! | #REF! | #REF!
25 | #REF! | #REF! | #REF!
26 | #REF! | #REF! | #REF!
27 | #REF! | #REF! | #REF!
28 | #REF! | #REF! | #REF!
29 | #REF! | #REF! | #REF!
30 | #REF! | #REF! | #REF!
31 | #REF! | #REF! | #REF!
32 | #REF! | #REF! | #REF!
33 | #REF! | #REF! | #REF!
34 | #REF! | #REF! | #REF!
35 | #REF! | #REF! | #REF!
36 | #REF! | #REF! | #REF!
37 | #REF! | #REF! | #REF!
38 | #REF! | #REF! | #REF!
39 | #REF! | #REF! | #REF!
40 | #REF! | #REF! | #REF!
41 | #REF! | #REF! | #REF!
42 | #REF! | #REF! | #REF!
43 | #REF! | #REF! | #REF!
44 | #REF! | #REF! | #REF!
45 | #REF! | #REF! | #REF!
46 | #REF! | #REF! | #REF!
47 | #REF! | #REF! | #REF!
48 | #REF! | #REF! | #REF!
49 | #REF! | #REF! | #REF!
50 | #REF! | #REF! | #REF!
51 | #REF! | #REF! | #REF!
52 | #REF! | #REF! | #REF!
53 | #REF! | #REF! | #REF!
54 | #REF! | #REF! | #REF!
55 | #REF! | #REF! | #REF!
56 | #REF! | #REF! | #REF!
57 | #REF! | #REF! | #REF!
58 | #REF! | #REF! | #REF!
59 | 273687.72 | 273687.72 | #REF!
60 | 273687.72 | 273687.72 | 0.00

Sheet: Inversión Inicial
INVERSIÓN INICIAL
MES | GASTO1 | GASTO2 | GASTO3 | TOTAL GASTOS
1 |  |  |  | 0 | 2281.83 | Creo que no hay que poner nada en inversión inicial ya que como criterio lo consideré como costo fijo + variables
2 |  |  |  | 0 | 2281.83 | como criterio para poder decir cuánto invertir en todo
3 |  |  |  | 0 | 2281.83
4 |  |  |  | 0 | 2281.83
5 |  |  |  | 0 | 2281.83
6 |  |  |  | 0 | 2281.83
7 |  |  |  | 0 | 2817.83
8 |  |  |  | 0 | 2817.83
9 |  |  |  | 0 | 2817.83
10 |  |  |  | 0 | 2817.83
11 |  |  |  | 0 | 2817.83
12 |  |  |  | 0 | 2817.83
13 |  |  |  | 0 | 2817.83
14 |  |  |  | 0 | 2817.83
15 |  |  |  | 0 | 2817.83
16 |  |  |  | 0 | 2817.83
17 |  |  |  | 0 | 2817.83
18 |  |  |  | 0 | 2817.83
19 |  |  |  | 0
20 |  |  |  | 0
21 |  |  |  | 0
22 |  |  |  | 0
23 |  |  |  | 0
24 |  |  |  | 0
25 |  |  |  | 0
26 |  |  |  | 0
27 |  |  |  | 0
28 |  |  |  | 0
29 |  |  |  | 0
30 |  |  |  | 0
31 |  |  |  | 0
32 |  |  |  | 0
33 |  |  |  | 0
34 |  |  |  | 0
35 |  |  |  | 0
36 |  |  |  | 0
37 |  |  |  | 0
38 |  |  |  | 0
39 |  |  |  | 0
40 |  |  |  | 0
41 |  |  |  | 0
42 |  |  |  | 0
43 |  |  |  | 0
44 |  |  |  | 0
45 |  |  |  | 0
46 |  |  |  | 0
47 |  |  |  | 0
48 |  |  |  | 0
49 |  |  |  | 0
50 |  |  |  | 0
51 |  |  |  | 0
52 |  |  |  | 0
53 |  |  |  | 0
54 |  |  |  | 0
55 |  |  |  | 0
56 |  |  |  | 0
57 |  |  |  | 0
58 |  |  |  | 0
59 |  |  |  | 0
60 |  |  |  | 0
TOTAL |  |  |  | 0

Sheet: COSTOS FIJOS
COSTOS FIJOS
MES | Encargado de Stock (1) | Equipo de Venta (1) | Equipo de Ingeniería/ Jefe de Proyecto (1) | Equipo de Desarrollo (1) | Técnico de Ensamblado (1) | COSTOS TOTALES
1 | 0.00 | 154.00 | 795.31 | 320.32 | 0.00 | 1269.63 | Marzo |  | Lucho | 7.28 | 1164
2 | 0.00 | 0.00 | 1406.99 | 800.80 | 0.00 | 2207.79 | Abril |  | Damian | 10.27 | 1643
3 | 0.00 | 231.00 | 1637.04 | 611.52 | 0.00 | 2479.56 | Mayo |  | Adrián | 7.7 | 1232
4 | 0.00 | 338.80 | 1129.70 | 232.96 | 0.00 | 1701.46 | Junio |  | Pablo | 5.99 | 958.4
5 | 0.00 | 431.20 | 1139.97 | 524.16 | 0.00 | 2095.33 | Julio |  | Marcelo | 9.42 | 1507.2
6 | 0.00 | 0.00 | 410.80 | 611.52 | 0.00 | 1022.32
7 | 0.00 | 0.00 | 400.53 | 844.48 | 0.00 | 1245.01 | Septiembre
8 | 47.92 | 63.14 | 872.95 | 946.40 | 0.00 | 1930.41
9 | 203.66 | 130.90 | 1386.45 | 669.76 | 0.00 | 2390.77 | Noviembre
10 | 323.46 | 154.00 | 1109.16 | 902.72 | 0.00 | 2489.34 | Diciembre
11 | 299.50 | 0.00 | 534.04 | 771.68 | 0.00 | 1605.22 | Enero
12 | 215.64 | 46.20 | 626.47 | 582.40 | 188.40 | 1659.11 | Febrero
13 | 383.36 | 30.80 | 759.98 | 626.08 | 226.08 | 2026.30 | Marzo | Acá se pueden agregar horas si no da
14 | 103.03 | 0.00 | 790.79 | 378.56 | 0.00 | 1272.38
15 | 0.00 | 0.00 | 718.90 | 626.08 | 0.00 | 1344.98
16 | 0.00 | 0.00 | 718.90 | 728.00 | 0.00 | 1446.90 | Junio
17 | 0.00 | 0.00 | 534.04 | 305.76 | 0.00 | 839.80
18 | 0.00 | 0.00 | 492.96 | 276.64 | 0.00 | 769.60
19 | 0.00 | 0.00 | 308.10 | 101.92 | 565.20 | 975.22 | Septiembre
20 |  |  |  |  |  | 0.00 | Octubre
21 | 1576.57 | 1580.04 | 15773.08 | 10861.76 | 979.68 | 30771.13
22 |  |  |  |  |  | 0.00
23 |  |  |  |  |  | 0.00
24 |  |  |  |  |  | 0.00
25 |  |  |  |  |  | 0.00
26 |  |  |  |  |  | 0.00
27 |  |  |  |  |  | 0.00
28 |  |  |  |  |  | 0.00
29 |  |  |  |  |  | 0.00
30 |  |  |  |  |  | 0.00
31 |  |  |  |  |  | 0.00
32 |  |  |  |  |  | 0.00
33 |  |  |  |  |  | 0.00
34 |  |  |  |  |  | 0.00
35 |  |  |  |  |  | 0.00
36 |  |  |  |  |  | 0.00
37 |  |  |  |  |  | 0.00
38 |  |  |  |  |  | 0.00
39 |  |  |  |  |  | 0.00
40 |  |  |  |  |  | 0.00
41 |  |  |  |  |  | 0.00
42 |  |  |  |  |  | 0.00
43 |  |  |  |  |  | 0.00
44 |  |  |  |  |  | 0.00
45 |  |  |  |  |  | 0.00
46 |  |  |  |  |  | 0.00
47 |  |  |  |  |  | 0.00
48 |  |  |  |  |  | 0.00
49 |  |  |  |  |  | 0.00
50 |  |  |  |  |  | 0.00
51 |  |  |  |  |  | 0.00
52 |  |  |  |  |  | 0.00
53 |  |  |  |  |  | 0.00
54 |  |  |  |  |  | 0.00
55 |  |  |  |  |  | 0.00
56 |  |  |  |  |  | 0.00
57 |  |  |  |  |  | 0.00
58 |  |  |  |  |  | 0.00
59 |  |  |  |  |  | 0.00
60 |  |  |  |  |  | 0.00
TOTAL |  |  |  |  |  | 61542.25
MATERIALES DE INVERSIÓN PARA DESARROLLO Y PRUEBAS
Prototipo

Sheet: COSTOS VARIABLES
COSTOS VARIABLES
MES | Armado De Placa | Armado De Gabinete | Ensamblado y Montaje | COSTO UNITARIO TOTAL | UNIDADES | COSTO TOTAL
1 | 87.14 | 181.28 | 60.00 | 327.41 | 0 | 0.00 | Acá hay que tener cuidado porque si bien yo consideré monto de inversión por una cantidad X
2 | 87.14 | 181.28 | 60.00 | 327.41 | 0 | 0.00 | de nodos en realidad no se producieron con lo cual no es un costo actual..eso hay que verlo
3 | 87.14 | 181.28 | 60.00 | 327.41 | 0 | 0.00 | saber si es necesario simular que hay una cantidad X de nodos o simplemente no considerarlos y considerar solamente el total en inversion en la hoja de resumen
4 | 87.14 | 181.28 | 60.00 | 327.41 | 0 | 0.00
5 | 87.14 | 181.28 | 60.00 | 327.41 | 0 | 0.00
6 | 87.14 | 181.28 | 60.00 | 327.41 | 10 | 3274.10
7 | 87.14 | 181.28 | 60.00 | 327.41 | 0 | 0.00
8 | 87.14 | 181.28 | 60.00 | 327.41 | 0 | 0.00
9 | 87.14 | 181.28 | 60.00 | 327.41 | 0 | 0.00
10 | 87.14 | 181.28 | 60.00 | 327.41 | 0 | 0.00
11 | 87.14 | 181.28 | 60.00 | 327.41 | 0 | 0.00
12 | 87.14 | 181.28 | 60.00 | 327.41 | 20 | 6548.20
13 | 87.14 | 181.28 | 60.00 | 327.41 | 0 | 0.00
14 | 87.14 | 181.28 | 60.00 | 327.41 | 0 | 0.00
15 | 87.14 | 181.28 | 60.00 | 327.41 | 0 | 0.00
16 | 87.14 | 181.28 | 60.00 | 327.41 | 0 | 0.00
17 | 87.14 | 181.28 | 60.00 | 327.41 | 0 | 0.00
18 | 87.14 | 181.28 | 60.00 | 327.41 | 20 | 6548.20
19 | 87.14 | 181.28 | 60.00 | 327.41 | 0 | 0.00
20 | 87.14 | 181.28 | 60.00 | 327.41 | 0 | 0.00
21 | 87.14 | 181.28 | 60.00 | 327.41 | 0 | 0.00
22 | 87.14 | 181.28 | 60.00 | 327.41 | 0 | 0.00
23 | 87.14 | 181.28 | 60.00 | 327.41 | 0 | 0.00
24 | 87.14 | 181.28 | 60.00 | 327.41 | 20 | 6548.20
25 | 87.14 | 181.28 | 60.00 | 327.41 | 0 | 0.00
26 | 87.14 | 181.28 | 60.00 | 327.41 | 0 | 0.00
27 | 87.14 | 181.28 | 60.00 | 327.41 | 0 | 0.00
28 | 87.14 | 181.28 | 60.00 | 327.41 | 0 | 0.00
29 | 87.14 | 181.28 | 60.00 | 327.41 | 0 | 0.00
30 | 87.14 | 181.28 | 60.00 | 327.41 | 30 | 9822.30
31 | 87.14 | 181.28 | 60.00 | 327.41 | 0 | 0.00
32 | 87.14 | 181.28 | 60.00 | 327.41 | 0 | 0.00
33 | 87.14 | 181.28 | 60.00 | 327.41 | 0 | 0.00
34 | 87.14 | 181.28 | 60.00 | 327.41 | 0 | 0.00
35 | 87.14 | 181.28 | 60.00 | 327.41 | 0 | 0.00
36 | 87.14 | 181.28 | 60.00 | 327.41 | 20 | 6548.20
37 | 87.14 | 181.28 | 60.00 | 327.41 | 0 | 0.00
38 | 87.14 | 181.28 | 60.00 | 327.41 | 0 | 0.00
39 | 87.14 | 181.28 | 60.00 | 327.41 | 0 | 0.00
40 | 87.14 | 181.28 | 60.00 | 327.41 | 0 | 0.00
41 | 87.14 | 181.28 | 60.00 | 327.41 | 0 | 0.00
42 | 87.14 | 181.28 | 60.00 | 327.41 | 20 | 6548.20
43 | 87.14 | 181.28 | 60.00 | 327.41 | 0 | 0.00
44 | 87.14 | 181.28 | 60.00 | 327.41 | 0 | 0.00
45 | 87.14 | 181.28 | 60.00 | 327.41 | 0 | 0.00
46 | 87.14 | 181.28 | 60.00 | 327.41 | 0 | 0.00
47 | 87.14 | 181.28 | 60.00 | 327.41 | 0 | 0.00
48 | 87.14 | 181.28 | 60.00 | 327.41 | 10 | 3274.10
49 | 87.14 | 181.28 | 60.00 | 327.41 | 0 | 0.00
50 | 87.14 | 181.28 | 60.00 | 327.41 | 0 | 0.00
51 | 87.14 | 181.28 | 60.00 | 327.41 | 0 | 0.00
52 | 87.14 | 181.28 | 60.00 | 327.41 | 0 | 0.00
53 | 87.14 | 181.28 | 60.00 | 327.41 | 0 | 0.00
54 | 87.14 | 181.28 | 60.00 | 327.41 | 0 | 0.00
55 | 87.14 | 181.28 | 60.00 | 327.41 | 0 | 0.00
56 | 87.14 | 181.28 | 60.00 | 327.41 | 0 | 0.00
57 | 87.14 | 181.28 | 60.00 | 327.41 | 0 | 0.00
58 | 87.14 | 181.28 | 60.00 | 327.41 | 0 | 0.00
59 | 87.14 | 181.28 | 60.00 | 327.41 | 0 | 0.00
60 | 87.14 | 181.28 | 60.00 | 327.41 | 0 | 0.00
TOTAL |  |  |  |  |  | 49111.50

Sheet: Auxiliar
GRAFICO
 |  |  |  |  | Tasa | 0.15% | $993226.56
MES | INGRESOS ACUMULADOS | EGRESOS ACUMULADOS | ING-EGRESOS | I-E AJUSTADO | PERIODOS | FLUJO NORMAL
1 | 0.00 | 0.00 | -12080.06 | -12080.06 | 1 | -12080.06
2 | 0.00 | 0.00 | -23641.30 | -23624.46 | 2 | -23641.30
3 | 0.00 | 0.00 | -32067.67 | -32026.32 | 3 | -32067.67
4 | 0.00 | 0.00 | -43330.89 | -43240.42 | 4 | -43330.89
5 | 0.00 | 0.00 | -78700.39 | -78404.39 | 5 | -78700.39
6 | 80000.00 | -125312.25 | -45312.25 | -45258.60 | 6 | -45312.25
7 | 180000.00 | -208433.36 | -28433.36 | -28526.61 | 7 | -28433.36
8 | 300000.00 | -265087.60 | 34912.40 | 34176.40 | 8 | 34912.40
9 | 420000.00 | -366083.87 | 53916.13 | 52959.91 | 9 | 53916.13
10 | 540000.00 | -413895.74 | 126104.26 | 124207.66 | 10 | 126104.26
11 | 640000.00 | -504849.30 | 135150.70 | 133123.25 | 11 | 135150.70
12 | 740000.00 | -543218.80 | 196781.20 | 193773.92 | 12 | 196781.20
13 | 820000.00 | -617339.65 | 202660.35 | 199551.18 | 13 | 202660.35
14 | 900000.00 | -646266.77 | 253733.23 | 249665.83 | 14 | 253733.23
15 | 960000.00 | -686312.28 | 273687.72 | 269217.43 | 15 | 273687.72
16
17
18
19
20
21
22
23
24
25
26
27
28
29
30
31
32
33
34
35
36
37
38
39
40
41
42
43
44
45
46
47
48
49
50
51
52
53
54
55
56
57
58
59 | 960000.00 | -686312.28 | 273687.72 | 269217.43 | 59 | 273687.72
60 | 960000.00 | -686312.28 | 273687.72 | 269217.43 | 60 | 273687.72

Sheet: Consumo
 | Sleep [mA] | Calculo Logica [mA] | Tx [mA] | Rx [mA] | Tiempo Calculo[Seg] | Tiempo Tx [Seg] | Tiempo RX[Seg] | Periodo transmision [Seg] | Periodo de Tx y Rx de paq[Seg] | Sleep [Seg] | ConsumoEspera[mA] | TiempoEspera [Seg]
Regulador 5V (LM2940-5) | 7.2 | 33.94 | 130.91 | 20.61 | 7 | 0.096 | 0.084 | 3600 | 3.28 | 3546.48 | 10 | 3.1
mDot | 0.05 | 33.94 | 130.91
Comparadores TS3V393 x 2 | 0.02 | 0.02 | 0.02
Comparadores TS3V393 x 4 | 0.04 | 0.04 | 0.04
Comparadores TS3V393 x 6 | 0.06 | 0.06 | 0.06
Comparadores TS3V393 x 8 | 0.08 | 0.08 | 0.08
 |  |  |  |  |  |  |  |  | Se envía cada 15 minutos, por eso *4
 |  |  | 25534.656 | 950.3030303 | 50.27 | 6.923636364 | 124 |  | 7.407264377 | Promedio de consumo en 1 hora en mA x hora
 |  |  | 26.66615176 | Lo paso a A*segundo |  |  |  | Con bateria de 2.3A/h en hs | 310.5059956 | Con bateria de 7A/h en hs | 945.0182474
 |  |  | 0.04444358626 | A/h enviando 6 veces en 1 hora |  |  |  | En días | 12.93774982 | En días | 39.37576031
 |  |  | 7.466522492 | Para que dure 7 dias
 |  |  | 1.61
