quirogaluistomas/MDot_Caudal_Proyecto_2/Listado Materiales Medidor Caudal LoRaWAN Lucho con bat 7Ah.xlsx

Sheet: Armado Placa
Materiales | Detalle | Responsable | Cantidad | Proveedor | Costo Unitario (USD) | IVA | Costo parcial (USD) | Costo 8 ch (USD) | Estado
mDot | MTDOT-915-AU-X1P-SMA-1 |  | 1 | Multitech | 32 | 0.21 | 38.72 | 38.72
Resistencias R2 | Valor 1M 1% 1/4 W |  | 8 | SYC | 0.025 | 0.21 | 0.03025 | 0.242
Resistencias R3 | Valor 220K 1% 1/4 W |  | 8 | SYC | 0.025 | 0.21 | 0.03025 | 0.242
Resistencias R4 | Valor 220 1% 1/4 W |  | 4 | SYC | 0.025 | 0.21 | 0.03025 | 0.121 |  | Este reemplaza a la resistencia de 240 del 317.
Resistencias R5 | Valor 1K 1% 1/4 W |  | 2 | SYC | 0.025 | 0.21 | 0.03025 | 0.0605
Resistencia R6 | Valor 56k 1% 1/4 W |  | 3 | SYC | 0.025 | 0.21 | 0.03025 | 0.09075
Preset vertical | Valor 5K - 3296x |  | 1 | SYC | 0.5 | 0.21 | 0.605 | 0.605
Capacitor Cerámico Disco C1 | 100nF |  | 1 | Microelectronica | 0.03 | 0.21 | 0.0363 | 0.0363
Capacitor Multicapa C5 | 330nF |  | 1 | Microelectronica | 0.03 | 0.21 | 0.0363 | 0.0363 |  | Este reemplaza al de de 470nF ceramico. Preguntar igual por el valor original
Capacitor Electrolitico 35V C2 | 22uF |  | 1 | Microelectronica | 0.05 | 0.21 | 0.0605 | 0.0605
Capacitor Electrolitico 100V C4 | 0.47uF |  | 1 | Microelectronica | 0.04 | 0.21 | 0.0484 | 0.0484 |  | Este en realidad se reemplaza por el de 1uF. Preguntar igual por el valor original
Tira de Pines Hembra p/ USB x 10 | 2,54 mm pitch |  | 1 | Cicem SRL | 0.13 | 0.21 | 0.1573 | 0.1573
Tira de Pines Macho p/ JMP x 20 | 2,54 mm pitch |  | 1 | Cicem SRL | 0.13 | 0.21 | 0.1573 | 0.1573
Tira de Pines Macho p/ PCB x 10 | 2 mm pitch |  | 1 | Microelectronica | 0.474 | 0.21 | 0.57354 | 0.57354
Tira de Pines Hembra p/ PCB x 10 | 2 mm pitch |  | 2 | Microelectronica | 0.474 | 0.105 | 0.52377 | 1.04754
Comparador Ultra bajo consumo | TS3v3 |  | 4 | Cicem SRL | 0.84 | 0.105 | 0.9282 | 3.7128
Zocalo | DIP-8 |  | 4 | Microelectronica | 0.075 | 0.21 | 0.09075 | 0.363
Diodo | 1n4007 |  | 2 | SYC | 0.025 | 0.105 | 0.027625 | 0.05525
Diodo Schottky | SYC 1N5817 |  | 8 | SYC | 0.06 | 0.105 | 0.0663 | 0.5304
Diodo Zener 20V | 1N5357 20V 1W |  | 1 | Microelectronica | 0.121 | 0.105 | 0.133705 | 0.133705
Jumper largo con cola | pitch 2,54 mm |  | 2 | Microelectronica | 0.072 | 0.21 | 0.08712 | 0.17424
Push Button | Tact switch 4.3 mm |  | 2 | SYC | 0.08 | 0.105 | 0.0884 | 0.1768
Transistor | BC337 |  | 3 | SYC | 0.05 | 0.105 | 0.05525 | 0.16575
Led Azul | 5 mm |  | 1 | Microelectronica | 0.0894 | 0.105 | 0.098787 | 0.098787
Led Verde | 5 mm |  | 1 | Microelectronica | 0.0726 | 0.105 | 0.080223 | 0.080223
Led Rojo | 5 mm |  | 1 | Microelectronica | 0.0552 | 0.105 | 0.060996 | 0.060996
Regulador Voltaje | LM317T |  | 1 | SYC | 0.4 | 0.105 | 0.442 | 0.442
Regulador Voltaje 5V | LM2940 |  | 1 | SYC | 1.6 | 0.105 | 1.768 | 1.768
Disipador | para TO-220 |  | 1 | SYC | 1.1 | 0.21 | 1.331 | 1.331
Borneras 3 vias a 90 para PCB | Hembra |  | 8 | SYC | 0.57 | 0.105 | 0.62985 | 5.0388
Borneras 2 vias a 90 para PCB | Hembra |  | 3 | SYC | 0.35 | 0.105 | 0.38675 | 1.16025
Porta Fuse PCB | 20x5 mm |  | 1 | Microelectronica | 0.46 | 0.21 | 0.5566 | 0.5566
PCB | Impreso doble Faz con TH y Serigrafia |  | 1 | EYCOM | 26.33 | 0.105 | 29.09465 | 29.09465
Total |  |  |  |  |  |  |  | 87.141681
 | Costo Referencia - Se debe Confirmar
 | Faltante - Se debe Comprar
Tarea | Detalle
Diseño circuito impreso | Damez - 1 ingeniero
horas programacion uC | Damez - 1 ingeniero
horas programacion App Windows | Damez - 1 ingeniero
horas diseño hardware | Damez - 1 ingeniero
Horas Armado c/PCB y pruebas | Damez - 1 ingeniero | 5 hrs soldado componentes
Horas creacion Documentacion

Sheet: Armado Gabinete
Materiales | Detalle | Unidades | Proveedor | Costo Unitario (USD) | IVA | costo Parcial (USD) | Costo 1 Kit (USD) | Estado
Gabinete estanco Q Energy | bandeja 230X280X140 código 17232814 | 1 | Genrod | 26.85 | 0.21 | 32.4885 | 32.4885 | FALTA
Kit fijacion gabinete Q Energy |  | 1 | Genrod | 4.54 | 0.21 | 5.4934 | 5.4934 | FALTA
Bateria 12v Acido 7Ah | Ver precio | 1 | DGA Electronica | 11.42 | 0.21 | 13.8182 | 13.8182 | FALTA
Soporte Bateria | Soporte aluminio | 1 | Damez | 2 |  | 2 | 2 | FALTA
Panel Solar 12V 3W |  | 1 | Solartec | 7.5 |  | 7.5 | 7.5 | FALTA
Pig tail 50cm RP SMA macho invertido a 90° a N Hembra pasachapa + Cable RG58 |  | 1 | Damez | 9.89 | 0.21 | 11.9669 | 11.9669 | Stock
Antena 900 MHz 6 dbi Omni HG906UP-NF + Soporte | L-com 900 Mhz | 1 | L-Com | 87.26 |  | 87.26 | 87.26 | Stock
Torres separadoras | metalicas 15mm | 4 | Microelectronica | 0.638 | 0.21 | 0.77198 | 3.08792 | FALTA
Varios | Cables, termocontraibles, terminales | 1 | Damez | 2 | 0.21 | 2.42 | 2.42
Chapa Identificatoria | 10x10 cm | 1 |  | 11.04 |  | 11.04 | 11.04
Prensacables 1/4" |  | 8 |  | 0.33 | 0.21 | 0.3993 | 3.1944
Total |  |  |  |  |  |  | 180.26932
 | Costo Referencia - Se debe Confirmar
 | Faltante - Se debe Comprar
Tarea | Detalle | Horas | Proveedor | Precio Unitario USD | Precio Total USD |  | Total USD
Horas Armado RTU y pruebas | Conforme a Ingeniería | 6 |  | 10 | 60 |  | 240.26932

Sheet: Consumo
 | Sleep [mA] | Calculo Logica [mA] | Tx [mA] | Rx [mA] | Tiempo Calculo[Seg] | Tiempo Tx [Seg] | Tiempo RX[Seg] | Periodo transmision [Seg] | Periodo de Tx y Rx de paq[Seg] | Sleep [Seg] | ConsumoEspera[mA] | TiempoEspera [Seg]
Regulador 5V (LM2940-5) | 7.2 | 33.94 | 130.91 | 20.61 | 7 | 0.096 | 0.084 | 3600 | 3.28 | 3546.48 | 10 | 3.1
mDot | 0.05 | 33.94 | 130.91
Comparadores TS3V393 x 2 | 0.02 | 0.02 | 0.02
Comparadores TS3V393 x 4 | 0.04 | 0.04 | 0.04
Comparadores TS3V393 x 6 | 0.06 | 0.06 | 0.06
Comparadores TS3V393 x 8 | 0.08 | 0.08 | 0.08
 |  |  |  |  |  |  |  |  | Se envía cada 15 minutos, por eso *4
 | Energia [mWh]
Comparadores TS3V393 x 8 - 8 ch | 43.02921657 |  | 25534.656 | 237.5757576 | 12.57 | 1.730909091 | 31 |  | 7.171536094 | Promedio de consumo en 1 hora en mA x hora
 |  |  | 25.81752994 | Lo paso a A*segundo |  |  |  | Con bateria de 2.3A/h en hs | 320.712323 | Con bateria de 7A/h en hs | 976.0809829
 |  |  | 0.04302921657 | A/h enviando 6 veces en 1 hora |  |  |  | En días | 13.36301346 | En días | 40.67004096
 |  |  | 7.228908383 | Para que dure 7 dias
 |  |  | 1.61
