quirogaluistomas/MDot_Caudal_Proyecto_2/Planillas de materiales/Factibilidad Economica - Cálculos.xlsx

La primera tanda sera de 500 u.
Costos indirectos |  | Costos directos
Alquiler | 50000.00 | Material | Cantidad | Costo Unitario (ARS) | Costo Total (ARS)
Secretario administrativo | 35000.00 | Fabricación de PCB | 1 | 63 | 63
Equipo de Ingeniería (3) | 210000.00 | Componentes circuitales | 30 | 100 | 3000
Equipo de Desarrollo (5) | 350000.00 | Regulador de alimentación | 1 | 200 | 200
Jefe de Proyecto | 100000.00 | Cables | 2 | 50 | 100
Servicios de limpieza | 25000.00 | Carcasa | 1 | 500 | 500
Electricidad + Agua + Gas | 30000.00 | Técnicos de ensamblado | 1 | 1000 | 1000
TOTAL 1 MES | 800000.00 | TOTAL |  |  | 4863
TOTAL 12 MESES | 9600000.00
Dividido 500 productos | 19200
Costo de una unidad de producto
 |  |  | 4.8 millones
Costo directo | 4863
Costo indirecto | 19200
Costo total | 24063
