quirogaluistomas/MDot_Caudal_Proyecto_2/Planillas de materiales/Listado Materiales Medidor Caudal LoRaWAN Damez 20201005.xlsx

Sheet: Armado Placa
Materiales | Detalle | Responsable | Unidades 2 ch | Unidades 4 ch | Unidades 6 ch | Unidades 8 ch | Proveedor | Costo Unitario (USD) | IVA | Costo parcial (USD) | Costo 4 ch (USD) | Costo 8 ch (USD) | Estado
mDot | MTDOT-915-AU-X1P-SMA-1 | Adri | 1 | 1 | 1 | 1 | Multitech | 32 | 0.21 | 38.72 | 38.72 | 38.72 | FALTA
Resistencias R1 | Valor 10k 5% 1/8 W | Damián | 2 | 4 | 6 | 8 | Cicem SRL | 0.011 | 0.21 | 0.01331 | 0.05324 | 0.10648 | Stock
Resistencias R2 | Valor 1M 1% 1/8 W | Damián | 2 | 4 | 6 | 8 | Cicem SRL | 0.011 | 0.21 | 0.01331 | 0.05324 | 0.10648 | Stock
Resistencias R3 | Valor 220K 1% 1/8 W | Damián | 2 | 4 | 6 | 8 | Cicem SRL | 0.011 | 0.21 | 0.01331 | 0.05324 | 0.10648 | Stock
Resistencias R4 | Valor 220 1% 1/8 W | Damián | 1 | 1 | 1 | 1 | Cicem SRL | 0.011 | 0.21 | 0.01331 | 0.01331 | 0.01331 | Stock
Resistencias R5 | Valor 1K 1% 1/8 W | Damián | 4 | 4 | 4 | 4 | Cicem SRL | 0.011 | 0.21 | 0.01331 | 0.05324 | 0.05324 | Stock
Preset vertical | Valor 5K - 3296x | Damián | 1 | 1 | 1 | 1 | Cicem SRL | 0.34 | 0.21 | 0.4114 | 0.4114 | 0.4114 | FALTA
Capacito Multicapa C1 | 100nF | Damián | 1 | 1 | 1 | 1 | Cicem SRL | 0.08 | 0.21 | 0.0968 | 0.0968 | 0.0968 | Stock
Capacitor Multicapa C5 | 330nF | Damián | 1 | 1 | 1 | 1 | Cicem SRL | 0.08 | 0.21 | 0.0968 | 0.0968 | 0.0968 | Stock
Capacitor Electrolitico 25V C2 | 22uF | Damián | 1 | 1 | 1 | 1 | Cicem SRL | 0.02 | 0.21 | 0.0242 | 0.0242 | 0.0242 | Stock
Capacitor Electrolitico 50V C4 | 0.47uF | Damián | 1 | 1 | 1 | 1 | Cicem SRL | 0.02 | 0.21 | 0.0242 | 0.0242 | 0.0242 | Stock
Tira de Pines Macho p/ PCB x 20 | 2,54 mm pitch | Damián | 1 | 1 | 1 | 1 | Cicem SRL | 0.13 | 0.21 | 0.1573 | 0.1573 | 0.1573 | FALTA
Tira de Pines Macho p/ PCB x 10 | 2 mm pitch | Damián | 1 | 1 | 1 | 1 | Microelectronica | 0.474 | 0.21 | 0.57354 | 0.57354 | 0.57354 | FALTA
Tira de Pines Hembra p/ PCB x 10 | 2 mm pitch | Damián | 2 | 2 | 2 | 2 | Microelectronica | 0.474 | 0.105 | 0.52377 | 1.04754 | 1.04754 | FALTA
Comparador Ultra bajo consumo | TS3v3 | Damián | 1 | 2 | 3 | 4 | Cicem SRL | 0.84 | 0.105 | 0.9282 | 1.8564 | 3.7128 | FALTA
Zocalo | DIP-8 | Damián | 1 | 2 | 3 | 4 | Microelectronica | 0.065 | 0.21 | 0.07865 | 0.1573 | 0.3146 | FALTA
Diodo | 1n4007 | Damián | 3 | 3 | 3 | 3 | Cicem SRL | 0.018 | 0.105 | 0.01989 | 0.05967 | 0.05967 | FALTA
Diodo Schottky | SYC 1N5817 - uelec BAT85 | Damián | 2 | 4 | 6 | 8 | Microelectronica | 0.1471 | 0.105 | 0.1625455 | 0.650182 | 1.300364 | FALTA
Jumper largo con cola | pitch 2,54 mm | Damián | 2 | 2 | 2 | 2 | Microelectronica | 0.072 | 0.21 | 0.08712 | 0.17424 | 0.17424
Push Button | Tact switch 4.3 mm | Damián | 2 | 2 | 2 | 2 | Cicem SRL | 0.0507 | 0.105 | 0.0560235 | 0.112047 | 0.112047 | FALTA
Transistor | BC337 | Damián | 1 | 1 | 1 | 1 | Cicem SRL | 0.035 | 0.105 | 0.038675 | 0.038675 | 0.038675 | FALTA
Led Rojo | 5 mm | Damián | 1 | 1 | 1 | 1 | Cicem SRL | 0.035 | 0.105 | 0.038675 | 0.038675 | 0.038675 | Stock
Regulador Voltaje | LM317T | Damián | 1 | 1 | 1 | 1 | Cicem SRL | 0.33 | 0.105 | 0.36465 | 0.36465 | 0.36465 | FALTA
Regulador Voltaje 5V | LM2940 | Damián | 1 | 1 | 1 | 1 | Microelectronica | 2.69 | 0.105 | 2.97245 | 2.97245 | 2.97245 | FALTA
disipador | para TO-220 | Damián | 1 | 1 | 1 | 1 | Microelectronica | 0.9 | 0.21 | 1.089 | 1.089 | 1.089
Borneras 3 vias a 90 para PCB | Hembra | Damián | 2 | 4 | 6 | 8 | Microelectronica | 0.48 | 0.105 | 0.5304 | 2.1216 | 4.2432 | FALTA
Borneras 3 vias | Enchufable | Damián | 2 | 4 | 6 | 8 | Microelectronica | 0.69 | 0.105 | 0.76245 | 3.0498 | 6.0996 | FALTA
Borneras 2 vias a 90 para PCB | Hembra | Damián | 2 | 2 | 2 | 2 | Microelectronica | 0.3 | 0.105 | 0.3315 | 0.663 | 0.663 | FALTA
Borneras 2 vias | Enchufable | Damián | 2 | 2 | 2 | 2 | Microelectronica | 0.65 | 0.105 | 0.71825 | 1.4365 | 1.4365 | FALTA
Porta Fuse PCB | 20x5 mm | Damián | 1 | 1 | 1 | 1 | Microelectronica | 0.46 | 0.21 | 0.5566 | 0.5566 | 0.5566 | FALTA
PCB | Impreso doble Faz con TH y Cerigrafia | Damián | 1 | 1 | 1 | 1 | Sperling | 9.3 | 0.105 | 10.2765 | 10.2765 | 10.2765 | FALTA
Total |  |  |  |  |  |  |  |  |  |  | 66.995339 | 74.990341
 | Costo Referencia - Se debe Confirmar
 | Faltante - Se debe Comprar
Tarea | Detalle |  | Horas | Nota
Diseño circuito impreso | Damez - 1 ingeniero |  | 60
horas programacion uC | Damez - 1 ingeniero |  | 150
horas programacion App Windows | Damez - 1 ingeniero |  | 150
horas diseño hardware | Damez - 1 ingeniero |  | 80
Horas Armado c/PCB y pruebas | Damez - 1 ingeniero | 5 hrs soldado componentes | 5 | Esto implicaria para cada placa
Horas creacion Documentacion |  |  | 40

Sheet: Armado Gabinete
Materiales | Detalle | Responsable | Unidades | Proveedor | Costo Unitario (USD) | IVA | costo Parcial (USD) | Costo 1 Kit (USD) | Estado
Gabinete estanco Q Energy | bandeja 230X280X140 código 17232814 | Marce G. | 1 | Genrod | 26.85 | 0.21 | 32.4885 | 32.4885 | FALTA
Kit fijacion gabinete Q Energy |  | Marce G. | 1 | Genrod | 4.54 | 0.21 | 5.4934 | 5.4934 | FALTA
Bateria 12v Acido 1.5Ah |  | Marce G. | 1 |  | 5 |  | 5 | 5 | FALTA
Soporte Bateria | Soporte aluminio | Damián | 1 | Damez | 2 |  | 2 | 2 | FALTA
Panel Solar 12V 3W |  | Marce G. | 1 | Solartec | 10 |  | 10 | 10 | FALTA
Pig tail 50cm SMA hembra invertido a 90° a N Hembra pasachapa | Conector según la antena a usar | Damián | 1 | Damez | 20 |  | 20 | 20 | Stock
Antena 900 MHz 3 dbi | L-com 900 Mhz rubber SMA | Adri | 1 | L-Com | 15 |  | 15 | 15 | Stock
Torres separadoras | metalicas 15mm | Damián | 4 | Microelectronica | 0.638 | 0.21 | 0.77198 | 3.08792 | FALTA
Varios | Cables, termocontraibles, terminales | Damián | 1 | Damez | 5 | 0.21 | 6.05 | 6.05
Chapa/Acrilico indentificador | 10x10 cm | Damián | 1 |  |  |  | 0 | 0
Pie de montaje con base cementada |  | Damián | 1 | Damez | 136 | 0.21 | 164.56 | 164.56
Total |  |  |  |  |  |  |  | 263.67982
 | Costo Referencia - Se debe Confirmar
 | Faltante - Se debe Comprar
Tarea | Detalle |  | Horas | Proveedor | Precio Unitario ($) | Precio Total ($)
Horas Armado RTU y pruebas |  |  | 4 |  | 0 | 0

Sheet: Para Pickup
Materiales | Responsable | Unidades | Costo Unitario (USD) | IVA | Costo Parcial (USD) | Costo 1 Kit (USD)
Caja Estanco 10x10x6 - 1 por pickup | Damián | 1
Conector para caja estanco - VER ROSCA pickup | Damián | 1
bornera interconexion para caja estanco de 2 vias | Damián | 1
Prensacable 1/4" | Damián | 1
Cable par trenzado mallado - 15mts x pickup | Damián | 1
Total

Sheet: Consumo
 | Sleep [mA] | Calculo Logica [mA] | Tx/Rx [mA] | Tiempo Calculo[Seg] | Tiempo TX/RX[Seg] | Periodo transmision [Seg] | Sleep [Seg]
Regulador 5V (LM7805 o LM2940-5) | 10 | 20 | 150 | 10 | 10 | 3600 | 3580
mDot | 0.05 | 20 | 130
Comparadores TS3V393 x 2 | 0.02 | 0.02 | 0.02
Comparadores TS3V393 x 4 | 0.04 | 0.04 | 0.04
Comparadores TS3V393 x 6 | 0.06 | 0.06 | 0.06
Comparadores TS3V393 x 8 | 0.08 | 0.08 | 0.08
 | Energia [mWh]
Comparadores TS3V393 x 2 - 2 ch | 62.91766667
Comparadores TS3V393 x 4 - 4 ch | 63.037
Comparadores TS3V393 x 6 - 6 ch | 63.15633333
Comparadores TS3V393 x 8 - 8 ch | 63.27566667
