quirogaluistomas/MDot_Caudal_Proyecto_2/Planillas de materiales/Listado Serie Medidor Caudal LoRaWAN Damez.xlsx

Sheet: RTU
# | Codigo Damez | Numero Serie | Componentes
1 | CAUDAL_LORAWAN_DMZ_V1.0.0 | 3486 | DEP_4CAUDAL_LORAWAN_V1.0.0, Panel Solar 6V 3W, bateria 6V4Ah, Jumper interno ufl a pasa chapa, Jumper N a N macho, Gabinete Genrod IP65, Antena 3dbi, Poste montaje 1.5 mts
2 | CAUDAL_LORAWAN_DMZ_V2.0.0 | 3570 | DEP_8CAUDAL_LORAWAN_V2.0.0, Panel Solar 12V 3W, bateria 12V2.3Ah, Jumper interno SMA a pasa chapa, Gabinete Genrod IP65, Antena 3dbi
3 | CAUDAL_LORAWAN_DMZ_V2.0.0 | 3571 | DEP_8CAUDAL_LORAWAN_V2.0.0, Panel Solar 12V 3W, bateria 12V2.3Ah, Jumper interno SMA a pasa chapa, Gabinete Genrod IP65, Antena 3dbi
4 | CAUDAL_LORAWAN_DMZ_V2.0.0 | 3572 | DEP_8CAUDAL_LORAWAN_V2.0.0, Panel Solar 12V 3W, bateria 12V2.3Ah, Jumper interno SMA a pasa chapa, Gabinete Genrod IP65, Antena 3dbi
5 | CAUDAL_LORAWAN_DMZ_V2.0.0 | 3573 | DEP_8CAUDAL_LORAWAN_V2.0.0, Panel Solar 12V 3W, bateria 12V2.3Ah, Jumper interno SMA a pasa chapa, Gabinete Genrod IP65, Antena 3dbi
6 | CAUDAL_LORAWAN_DMZ_V2.0.0 | 3574 | DEP_8CAUDAL_LORAWAN_V2.0.0, Panel Solar 12V 3W, bateria 12V2.3Ah, Jumper interno SMA a pasa chapa, Gabinete Genrod IP65, Antena 3dbi
7 | CAUDAL_LORAWAN_DMZ_V2.0.0 | 3575 | DEP_8CAUDAL_LORAWAN_V2.0.0, Panel Solar 12V 3W, bateria 12V2.3Ah, Jumper interno SMA a pasa chapa, Gabinete Genrod IP65, Antena 3dbi
8 | CAUDAL_LORAWAN_DMZ_V2.0.0 | 3576 | DEP_8CAUDAL_LORAWAN_V2.0.0, Panel Solar 12V 3W, bateria 12V2.3Ah, Jumper interno SMA a pasa chapa, Gabinete Genrod IP65, Antena 3dbi
9 | CAUDAL_LORAWAN_DMZ_V2.0.0 | 3577 | DEP_8CAUDAL_LORAWAN_V2.0.0, Panel Solar 12V 3W, bateria 12V2.3Ah, Jumper interno SMA a pasa chapa, Gabinete Genrod IP65, Antena 3dbi
10 | CAUDAL_LORAWAN_DMZ_V2.0.0 | 3578 | DEP_8CAUDAL_LORAWAN_V2.0.0, Panel Solar 12V 3W, bateria 12V2.3Ah, Jumper interno SMA a pasa chapa, Gabinete Genrod IP65, Antena 3dbi
11 | CAUDAL_LORAWAN_DMZ_V2.0.0 | 3579 | DEP_8CAUDAL_LORAWAN_V2.0.0, Panel Solar 12V 3W, bateria 12V2.3Ah, Jumper interno SMA a pasa chapa, Gabinete Genrod IP65, Antena 3dbi
12 | CAUDAL_LORAWAN_DMZ_V2.0.0 | 3580 | DEP_8CAUDAL_LORAWAN_V2.0.0, Panel Solar 12V 3W, bateria 12V2.3Ah, Jumper interno SMA a pasa chapa, Gabinete Genrod IP65, Antena 3dbi
13 | CAUDAL_LORAWAN_DMZ_V2.0.0 | 3581 | DEP_8CAUDAL_LORAWAN_V2.0.0, Panel Solar 12V 3W, bateria 12V2.3Ah, Jumper interno SMA a pasa chapa, Gabinete Genrod IP65, Antena 3dbi
14 | CAUDAL_LORAWAN_DMZ_V2.0.0 | 3582 | DEP_8CAUDAL_LORAWAN_V2.0.0, Panel Solar 12V 3W, bateria 12V2.3Ah, Jumper interno SMA a pasa chapa, Gabinete Genrod IP65, Antena 3dbi
15 | CAUDAL_LORAWAN_DMZ_V2.0.0 | 3583 | DEP_8CAUDAL_LORAWAN_V2.0.0, Panel Solar 12V 3W, bateria 12V2.3Ah, Jumper interno SMA a pasa chapa, Gabinete Genrod IP65, Antena 3dbi
16 | CAUDAL_LORAWAN_DMZ_V2.0.0 | 3584 | DEP_8CAUDAL_LORAWAN_V2.0.0, Panel Solar 12V 3W, bateria 12V2.3Ah, Jumper interno SMA a pasa chapa, Gabinete Genrod IP65, Antena 3dbi

Sheet: Seriado Nodo
# Equipos | OCI | Codigo Damez | LoteNEquipo | Cliente | Version Firm | Version PCB | Controlador | DevEUI | N# Serie mDot | N# Serie RTU
1 | 6117 | DEP_4CAUDAL_LORAWAN_V1.0.0 | 001N001 | Vista O&G | mdot_caudal_134 | DEP_CAUDAL_LORAWAN_V1.0.0 | MTDK xDot | 0080000004004B46 | 19368114 | 3486
2 | 6129 | DEP_8CAUDAL_LORAWAN_V2.0.0 | 002N001 | Vista O&G | MDot_Caudal_200_8AI | DEP_CAUDAL_LORAWAN_V2.0.0 | MTDOT-915-AU-X1P-SMA-1 | 008000000001600A | 20431041 | 3570
3 | 6129 | DEP_8CAUDAL_LORAWAN_V2.0.0 | 002N002 | Vista O&G | MDot_Caudal_200_8AI | DEP_CAUDAL_LORAWAN_V2.0.0 | MTDOT-915-AU-X1P-SMA-1 | 0080000000016004 | 20431035 | 3571
4 | 6129 | DEP_8CAUDAL_LORAWAN_V2.0.0 | 002N003 | Vista O&G | MDot_Caudal_200_8AI | DEP_CAUDAL_LORAWAN_V2.0.0 | MTDOT-915-AU-X1P-SMA-1 | 008000000001600E | 20431045 | 3572
5 | Lora-Caudal4-DMZ | DEP_4CAUDAL_LORAWAN_V2.0.0 | 002N004 | Damez |  | DEP_CAUDAL_LORAWAN_V2.0.0
6 | Lora-Caudal4-DMZ | DEP_4CAUDAL_LORAWAN_V2.0.0 | 002N005 | Damez |  | DEP_CAUDAL_LORAWAN_V2.0.0
7 | 6129 | DEP_8CAUDAL_LORAWAN_V2.0.1 | 003N001 | Vista O&G | MDot_Caudal_200_8AI | DEP_CAUDAL_LORAWAN_V2.0.1 | MTDOT-915-AU-X1P-SMA-1 | 0080000000015B23 | 20337598 | 3573
8 | 6129 | DEP_8CAUDAL_LORAWAN_V2.0.1 | 003N002 | Vista O&G | MDot_Caudal_200_8AI | DEP_CAUDAL_LORAWAN_V2.0.1 | MTDOT-915-AU-X1P-SMA-1 | 008000000001600D | 20431044 | 3574
9 | 6129 | DEP_8CAUDAL_LORAWAN_V2.0.1 | 003N003 | Vista O&G | MDot_Caudal_200_8AI | DEP_CAUDAL_LORAWAN_V2.0.1 | MTDOT-915-AU-X1P-SMA-1 | 0080000000016002 | 20431033 | 3575
10 | 6129 | DEP_8CAUDAL_LORAWAN_V2.0.1 | 003N004 | Vista O&G | MDot_Caudal_200_8AI | DEP_CAUDAL_LORAWAN_V2.0.1 | MTDOT-915-AU-X1P-SMA-1 | 0080000000016003 | 20431034 | 3576
11 | 6129 | DEP_8CAUDAL_LORAWAN_V2.0.1 | 003N005 | Vista O&G | MDot_Caudal_200_8AI | DEP_CAUDAL_LORAWAN_V2.0.1 | MTDOT-915-AU-X1P-SMA-1 | 0080000000016001 | 20431032 | 3577
12 | 6129 | DEP_8CAUDAL_LORAWAN_V2.0.1 | 003N006 | Vista O&G | MDot_Caudal_200_8AI | DEP_CAUDAL_LORAWAN_V2.0.1 | MTDOT-915-AU-X1P-SMA-1 | 008000000001600B | 20431042 | 3578
13 | 6129 | DEP_8CAUDAL_LORAWAN_V2.0.1 | 003N007 | Vista O&G | MDot_Caudal_200_8AI | DEP_CAUDAL_LORAWAN_V2.0.1 | MTDOT-915-AU-X1P-SMA-1 | 0080000000015B29 | 20337604 | 3579
14 | 6129 | DEP_8CAUDAL_LORAWAN_V2.0.1 | 003N008 | Vista O&G | MDot_Caudal_200_8AI | DEP_CAUDAL_LORAWAN_V2.0.1 | MTDOT-915-AU-X1P-SMA-1 | 0080000000016000 | 20431031 | 3580
15 | 6129 | DEP_8CAUDAL_LORAWAN_V2.0.1 | 003N009 | Vista O&G | MDot_Caudal_200_8AI | DEP_CAUDAL_LORAWAN_V2.0.1 | MTDOT-915-AU-X1P-SMA-1 | 0080000000015FFD | 20431028 | 3581
16 | 6129 | DEP_8CAUDAL_LORAWAN_V2.0.1 | 003N010 | Vista O&G | MDot_Caudal_200_8AI | DEP_CAUDAL_LORAWAN_V2.0.1 | MTDOT-915-AU-X1P-SMA-1 | 0080000000015FFE | 20431029 | 3582
17 | 6129 | DEP_8CAUDAL_LORAWAN_V2.0.1 | 003N011 | Vista O&G | MDot_Caudal_200_8AI | DEP_CAUDAL_LORAWAN_V2.0.1 | MTDOT-915-AU-X1P-SMA-1 | 008000000001600C | 20431043 | 3583
18 | 6129 | DEP_8CAUDAL_LORAWAN_V2.0.1 | 003N012 | Vista O&G | MDot_Caudal_200_8AI | DEP_CAUDAL_LORAWAN_V2.0.1 | MTDOT-915-AU-X1P-SMA-1 | 0080000000015FFF | 20431030 | 3584
