quirogaluistomas/MDot_Caudal_Proyecto_2/Planillas de materiales/Planilla para Mompo con precios.xlsx

Materiales | Detalle | Unidades | Proveedor | Costo Unitario (USD) | IVA | costo Parcial (USD) | Costo 1 Kit (USD) | Stock
Gabinete estanco Q Energy | bandeja 230X280X140 código 17232814 | 1 | Genrod | $6.35 |  | 6.354545455 | 6.354545455
Kit fijacion gabinete Q Energy |  | 1 | Genrod | $5.69 |  | 5.690430622 | 5.690430622
Bateria 12v Acido 2.3Ah | Ver precio | 1 | DGA Electronica | $6.60 |  | 6.602870813 | 6.602870813
Panel Solar 12V 3.25W |  | 1 | Solartec | USD 7.50 |  | 7.5 | 7.5
Pig tail 1m RP SMA macho invertido a 90° a N Hembra pasachapa + Cable RG58 | Puede venir el cable armado o los materiales por separado | 1 |  | USD 9.89 |  | 9.89 | 9.89
Antena 900 MHz 6 dbi Omni HG906UP-NF | L-com 900 Mhz | 1 | L-Com | $486.90 |  | 486.9 | 486.9
Chapa identificatoria | 10x10 cm | 1 |  | $1150.00 |  | 0 | 0
Pasacables 1/4" |  | 9 |  | $35.00 |  | 35 | 315
Total |  |  |  |  |  |  | 837.9378469
