quirogaluistomas/MDot_Caudal_Proyecto_2/Factibilidad Economica - Cálculos LoRa con Bat 7Ah.xlsx

La primera tanda en 18 meses será el equivalente de 70 unidades.
Costos indirectos |  |  | Costos directos
Encargado de Stock | 222.22 |  | Material | Cantidad | Costo Unitario (USD) | Costo Total (ARS)
Equipo de Venta (1) | 253.97 |  | Armado De Placa | 1 | 87.14 | 87.14
Equipo de Ingeniería/ Jefe de Proyecto (1) | 571.43 |  | Armado De Gabinete | 1 | 181.2857 | 181.2857
Equipo de Desarrollo (1) | 428.57 |  | Técnico de Ensamblado | 1 | 60 | 60
TOTAL 1 MES | 1476.19 |  | TOTAL |  |  | $328.43
TOTAL 18 MESES | 26571.43
Dividido 70 productos | $379.59
Costo de una unidad de producto
 |  |  |  |  | Inversión inicial
Costo directo | 328.4257 |  | Todo está en dólar oficial 1$ = 105 USD |  | Suponiendo 10 unidades | $3284.26
Costo indirecto | 379.5918367 |  | Tasa de interés en dolares es del 1.75% |  | Suponiendo 6 meses de C.Ind
Costo total | $708.02 |  |  |  | Se divide por mas el costo indirecto del personal debido a que existen ingresos de capital por otros lados. Ej: 2 solo Automatismo y por 3 si abarcan otros sectores de la empresa
 |  |  | Costo del producto con criterio de ecuacion
 |  |  | $2582.18
 |  |  | Costo con mismo criterio pero mayor
ESTA PLANILLA ES SOLO VENDIENDO EQUIPO SIN GW |  |  | $2926.47 |  |  | $8857.14
 |  |  | Costo con mismo criterio pero mayor aun
 |  |  | $3376.70 |  | Inversion inicial total USD | $12141.40
 |  |  |  |  | No voy a invertir todo de una, sino de a poco pero llegando a ese monto
Salario en Dolares | Mes | Dia | Hora
Encargado de Stock | 959.40 | 47.97 | 5.99625
Equipo de Venta (1) | 1096.46 | 54.82285714 | 6.852857143
Equipo de Ingeniería/ Jefe de Proyecto (1) | 1644.69 | 82.23428571 | 10.27928571
Equipo de Desarrollo (1) | 1164.99 | 58.24928571 | 7.281160714
Técnico de Ensamblado(1) | - | - | 10
Costo MOD
Luis | 11589.76
Damian | 10352.16
Adrián | 1200.12
Pablo | 1576.57
Marcelo | 1040
Costos por Tarea
Investigacion | 6955.5
Planificacion | 2414
Ingeniería | 6281.08
Compras | 2820.29
Programación | 2879.5
Construcción | 447.52
Ensayos | 212.12
Pruebas de funcionamiento | 1427.4
Testing Final | 993.2
Documentación | 1328
 | 25758.61
