quirogaluistomas/MDot_Caudal_Proyecto_2/Factibilidad Economica - Cálculos LoRa con Soft y bat 7Ah.xlsx

La primera tanda en 18 meses será el equivalente de 70 unidades.
Costos indirectos |  | Costos directos
Encargado de Stock | 222.22 | Material | Cantidad | Costo Unitario (USD) | Costo Total (USD)
Equipo de Venta (1) | 253.97 | Armado De Placa | 1 | 87.14 | 87.14
Equipo de Ingeniería/ Jefe de Proyecto (1) | 571.43 | Armado De Gabinete | 1 | 180.2693 | 180.2693
Equipo de Desarrollo (1) | 428.57 | Técnico de Ensamblado | 1 | 60 | 60
Limpieza | 174.60 | Agregado de paquete de Soft | 1 | 100 | 100
Electricidad + Agua + Gas | 95.24
TOTAL 1 MES | 1746.03 | TOTAL |  |  | $427.41
TOTAL 18 MESES | 31428.57
Dividido 70 productos | $448.98
Costo de una unidad de producto
 |  |  |  | Inversión inicial
Costo directo | 427.4093 | Todo está en dólar oficial 1$ = 105 USD |  | Suponiendo 10 unidades | $4274.09
Costo indirecto | 448.9795918 | Tasa de interés en dolares es del 1.75% |  | Suponiendo 6 meses de C.Ind
Costo total | $876.39 |  |  | Se divide por mas el costo indirecto del personal debido a que existen ingresos de capital por otros lados. Ej: 2 solo Automatismo y por 3 si abarcan otros sectores de la empresa
 |  | Costo del producto con criterio de geloso
 |  | $3196.24
 |  | Costo con mismo criterio pero mayor
ESTA PLANILLA ES SOLO VENDIENDO EQUIPO SIN GW |  | $3622.41 |  |  | $10476.19
 |  | Costo con mismo criterio pero mayor aun
 |  | $4179.70 |  | Inversion inicial total USD | $14750.28
 |  |  |  | No voy a invertir todo de una, sino de a poco pero llegando a ese monto
