quirogaluistomas/MDot_Caudal_Proyecto_2/Fotos de Mediciones - Prototipo/Todo deshabilitado y 1 señal/100Hz_1Vp_TiempoWakeyCalculo.jpg

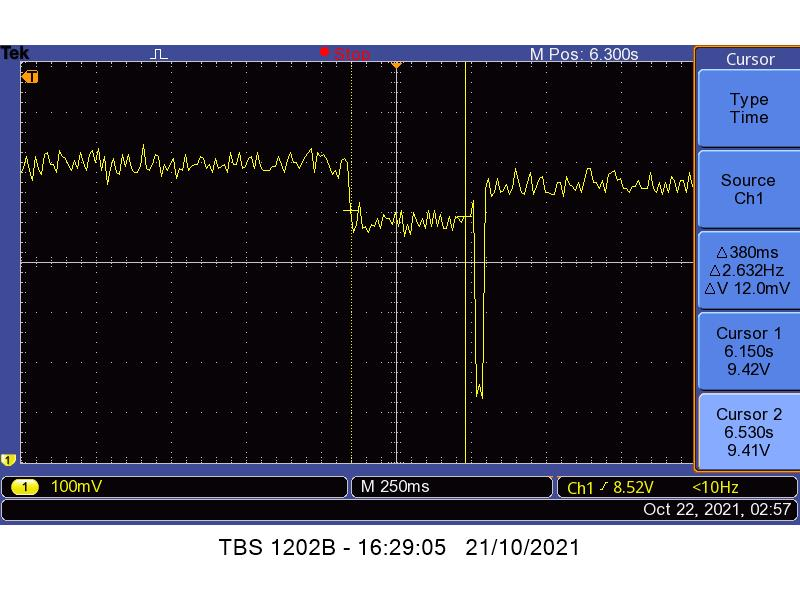
Fotos de Mediciones - Prototipo/Todo deshabilitado y 1 señal/100Hz_1Vp_TiempoWakeyCalculo.jpg
