quirogaluistomas/MDot_Caudal_Proyecto_2/Fotos de Mediciones - Prototipo/Todo habilitado y 1 señal/1kHz_1Vp_TensionEnvioPaquetesTotalesEstadoEstacionario_Rx.jpg

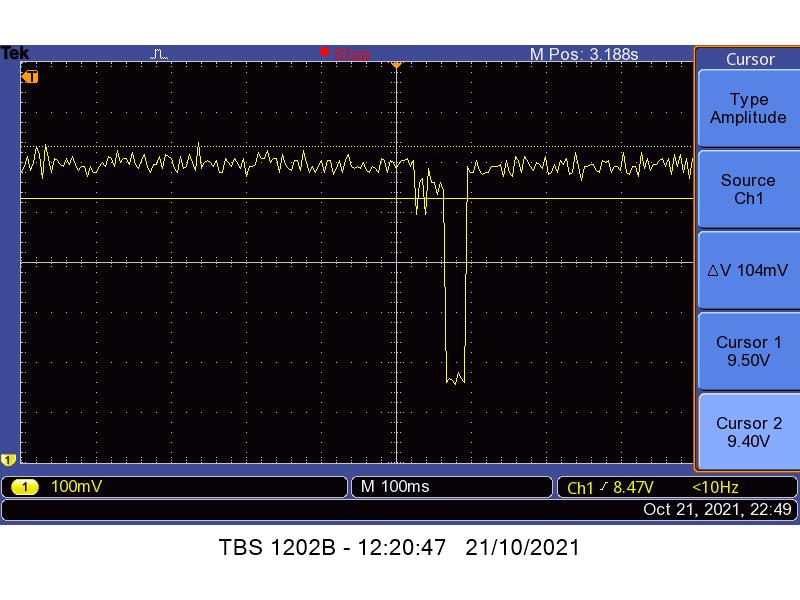
Fotos de Mediciones - Prototipo/Todo habilitado y 1 señal/1kHz_1Vp_TensionEnvioPaquetesTotalesEstadoEstacionario_Rx.jpg
