quirogaluistomas/MDot_Caudal_Proyecto_2/Test1/GerbersV1/Test1-B_Cu.pdf

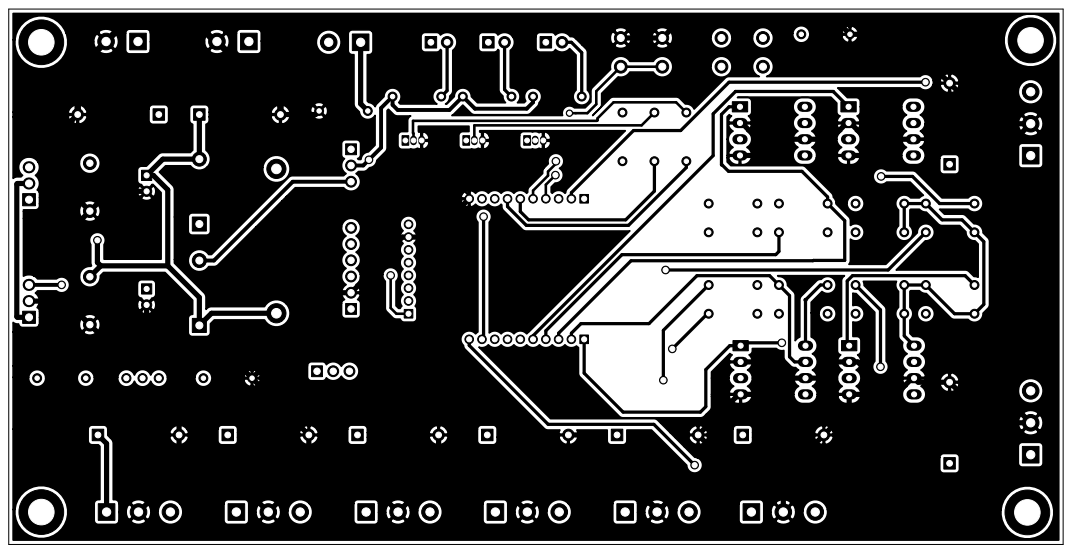
[picture p85: page 1]
