quirogaluistomas/MDot_Caudal_Proyecto_2/Test1/GerbersV1/Test1-F_Cu.pdf

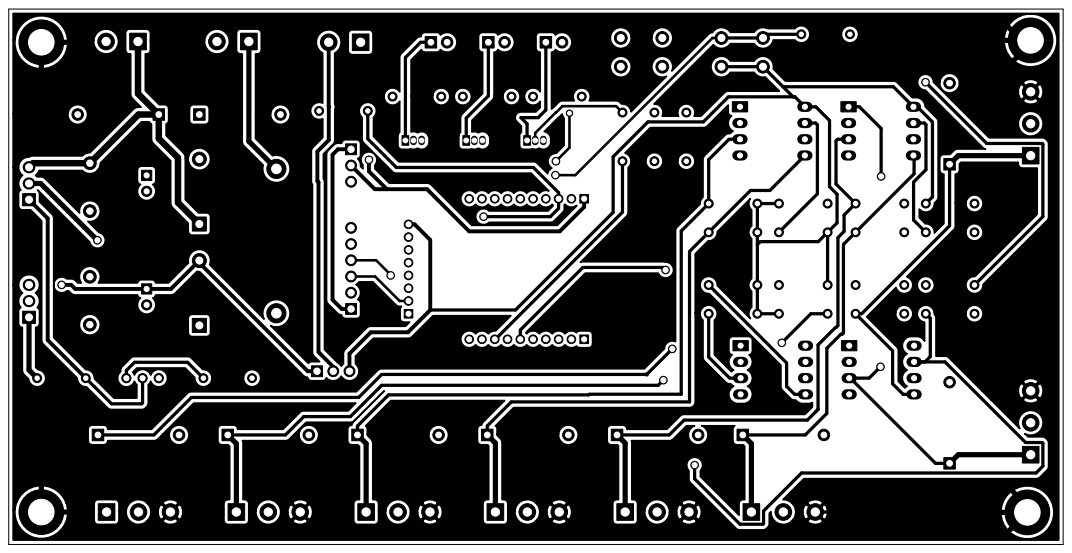
[picture p86: page 1]
