quirogaluistomas/MDot_Caudal_Proyecto_2/TP3 - Intro a Proy/TP3 - Intro a Proy/AON.pdf

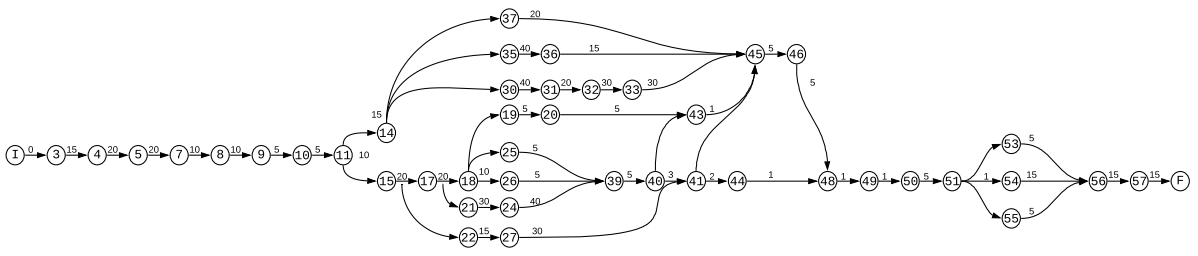
[picture p87: page 1]
