quirogaluistomas/MDot_Caudal_Proyecto_2/TP3 - Intro a Proy/TP3 - Intro a Proy/Tiempos.pdf

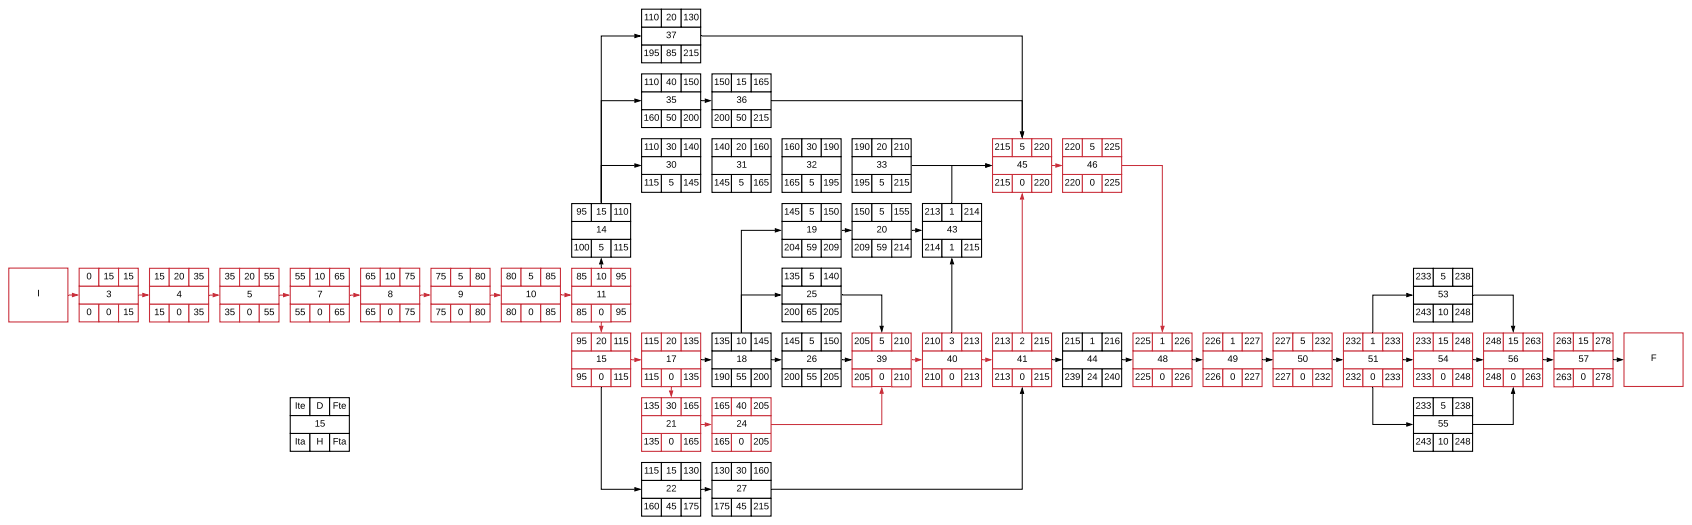
[picture p88: page 1]
Ita; Fta; Ite D Fte
