quirogaluistomas/MDot_Caudal_Proyecto_2/Test1/Test1.kicad_pcb

## KiCad design Test1/Test1.kicad_pcb (2021-10-14)

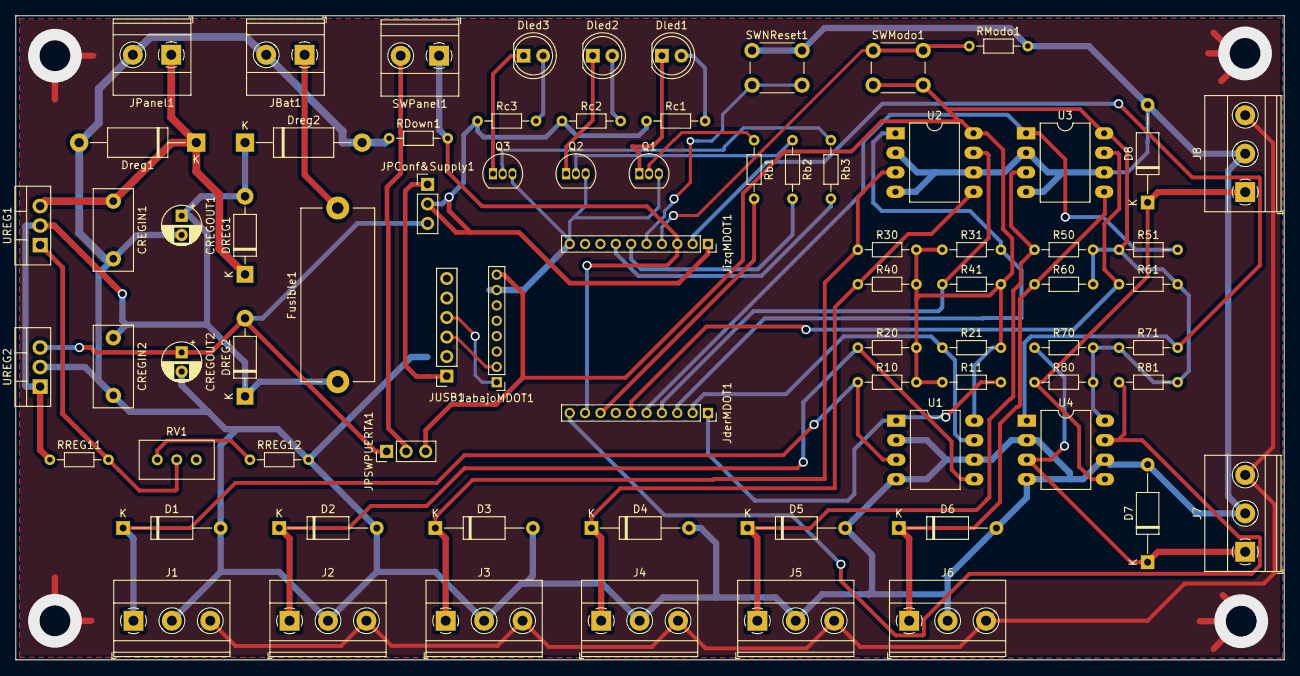
[picture p89: board Test1.kicad_pcb from above]

Board: 2 copper layers, 165.1 x 83.8 mm, 75 parts (0 on the bottom side), 44 nets.

Parts:
CREGIN1: 100n; C_Disc_D10.5mm_W5.0mm_P7.50mm
CREGIN2: 0.47u; C_Disc_D10.5mm_W5.0mm_P7.50mm
CREGOUT1: 1u; CP_Radial_D5.0mm_P2.50mm
CREGOUT2: 22u; CP_Radial_D5.0mm_P2.50mm
D1, D2, D3, D4, D5, D6, D7, D8: D; D_A-405_P12.70mm_Horizontal
DREG1, DREG2: 1N4007; D_DO-41_SOD81_P10.16mm_Horizontal
Dled1, Dled2, Dled3: LED; LED_D5.0mm
Dreg1, Dreg2: D_Zener; D_DO-15_P15.24mm_Horizontal
Fusible1: 1A, 25V; Fuseholder_Cylinder-5x20mm_Stelvio-Kontek_PTF78_Horizontal_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
J1, J2, J3, J4, J5, J6, J7, J8: Screw_Terminal_01x03; TerminalBlock_Phoenix_MKDS-1,5-3_1x03_P5.00mm_Horizontal
JBat1: Screw_Terminal_01x02; TerminalBlock_Phoenix_MKDS-1,5-2_1x02_P5.00mm_Horizontal
JPConf&Supply1: Jumper_3_Open; PinHeader_1x03_P2.54mm_Vertical
JPSWPUERTA1: Jumper_3_Open; PinHeader_1x03_P2.54mm_Vertical
JPanel1: Screw_Terminal_01x02; TerminalBlock_Phoenix_MKDS-1,5-2_1x02_P5.00mm_Horizontal
JUSB1: Conn_01x06_Female; PinSocket_1x06_P2.54mm_Vertical
JabajoMDOT1: Conn_01x08_Male; PinHeader_1x08_P2.00mm_Vertical
JderMDOT1: Conn_01x10_Female; PinSocket_1x10_P2.00mm_Vertical
JizqMDOT1: Conn_01x10_Female; PinSocket_1x10_P2.00mm_Vertical
Q1, Q2, Q3: BC337; TO-92_Inline
R10, R20, R30, R40, R50, R60, R70, R80: 1M; R_Axial_DIN0204_L3.6mm_D1.6mm_P7.62mm_Horizontal
R11, R21, R31, R41, R51, R61, R71, R81: 200k; R_Axial_DIN0204_L3.6mm_D1.6mm_P7.62mm_Horizontal
RDown1: 10k; R_Axial_DIN0204_L3.6mm_D1.6mm_P7.62mm_Horizontal
RModo1: 1k; R_Axial_DIN0204_L3.6mm_D1.6mm_P7.62mm_Horizontal
RREG11: 240; R_Axial_DIN0204_L3.6mm_D1.6mm_P7.62mm_Horizontal
RREG12: 1k; R_Axial_DIN0204_L3.6mm_D1.6mm_P7.62mm_Horizontal
RV1: 5k; Potentiometer_Bourns_3296W_Vertical
Rb1, Rb2, Rb3: 56k; R_Axial_DIN0204_L3.6mm_D1.6mm_P7.62mm_Horizontal
Rc1, Rc2, Rc3: 200; R_Axial_DIN0204_L3.6mm_D1.6mm_P7.62mm_Horizontal
SWModo1: SW_Push_Open_Dual; SW_PUSH_6mm_H4.3mm
SWNReset1: SW_Push_Open_Dual; SW_PUSH_6mm_H4.3mm
SWPanel1: SW_Push_Open_Dual; TerminalBlock_Phoenix_MKDS-1,5-2_1x02_P5.00mm_Horizontal
U1, U2, U3, U4: TS3V393_V1; DIP-8_W10.16mm_LongPads
UREG1: LM317_TO-252; TO-220-3_Vertical
UREG2: LM2931-5.0_TO220; TO-220-3_Vertical

Connections:
3VMdot: JPSWPUERTA1.3, JabajoMDOT1.8, R10.2, R11.1, R20.2, R21.2, R30.2, R31.1, R40.2, R41.2, R50.2, R51.1, R60.2, R61.2, R70.2, R71.1, R80.2, R81.2, SWModo1.2, U1.8, U2.8, U3.8, U4.8
5VUSB: JPConf&Supply1.1, JUSB1.1
+12V: CREGIN1.1, DREG1.1, Dreg1.1, JPanel1.1, UREG1.3
AI1: JderMDOT1.1, R11.2, U1.1
AI2: JderMDOT1.2, R21.1, U1.7
AI3: JderMDOT1.3, R31.2, U2.1
AI4: JderMDOT1.4, R41.1, U2.7
AI5: JderMDOT1.5, R51.2, U3.1
AI6: JderMDOT1.6, R61.1, U3.7
AI7: JizqMDOT1.2, R71.2, U4.1
AI8: JderMDOT1.10, R81.1, U4.7
DIPuerta: JderMDOT1.9, JizqMDOT1.3, RDown1.2, SWPanel1.1
DO1: JderMDOT1.8, Rb1.2
DO2: JizqMDOT1.6, Rb2.2
DO3: JizqMDOT1.7, Rb3.2
GND: CREGIN1.2, CREGIN2.2, CREGOUT1.2, CREGOUT2.2, D1.2, D2.2, D3.2, D4.2, D5.2, D6.2, D7.2, D8.2, Dreg1.2, Dreg2.2, J1.2, J2.2, J3.2, J4.2, J5.2, J6.2, J7.2, J8.2, JBat1.2, JPanel1.2, JUSB1.2, JabajoMDOT1.7, JizqMDOT1.10, Q1.3, Q2.3, Q3.3, RDown1.1, RModo1.2, RREG12.2, SWNReset1.1, U1.2, U1.4, U1.6, U2.2, U2.4, U2.6, U3.2, U3.4, U3.6, U4.2, U4.4, U4.6, UREG2.2
unnamed: D1.1, J1.1, R10.1, U1.3
unnamed: D2.1, J2.1, R20.1, U1.5
unnamed: D3.1, J3.1, R30.1, U2.3
unnamed: D4.1, J4.1, R40.1, U2.5
unnamed: D5.1, J5.1, R50.1, U3.3
unnamed: D6.1, J6.1, R60.1, U3.5
unnamed: D7.1, J7.1, R70.1, U4.3
unnamed: D8.1, J8.1, R80.1, U4.5
unnamed: Dled1.1, Q1.1
unnamed: Dled1.2, Rc1.2
unnamed: Dled2.1, Q2.1
unnamed: Dled2.2, Rc2.2
unnamed: Dled3.1, Q3.1
unnamed: Dled3.2, Rc3.2
unnamed: Fusible1.2, JBat1.1
unnamed: J1.3, J2.3, J3.3, J4.3, J5.3, J6.3, J7.3, J8.3
unnamed: JPSWPUERTA1.2, SWPanel1.2
unnamed: JUSB1.3, JabajoMDOT1.2
unnamed: JUSB1.4, JabajoMDOT1.1
unnamed: JizqMDOT1.4, RModo1.1, SWModo1.1
unnamed: JizqMDOT1.5, SWNReset1.2
unnamed: Q1.2, Rb1.1
unnamed: Q2.2, Rb2.1
unnamed: Q3.2, Rb3.1
unnamed: RREG11.2, RV1.1, RV1.2, UREG1.1
unnamed: RREG12.1, RV1.3
Vbat: CREGIN2.1, CREGOUT1.1, DREG1.2, DREG2.1, Dreg2.1, Fusible1.1, RREG11.1, UREG1.2, UREG2.1
VccMDOT: CREGOUT2.1, DREG2.2, JPConf&Supply1.2, JPConf&Supply1.3, JPSWPUERTA1.1, JizqMDOT1.1, Rc1.1, Rc2.1, Rc3.1, UREG2.3
