quirogaluistomas/MDot_Caudal_Proyecto_2/(commit log)

2021-07-08 Armando el menu de configuración..
2021-07-25 Realizado hasta el envío de paquete. 25072021
2021-07-26 Realizado hasta envío de packets y cálculo de tiempos de sleep. 26072021
2021-07-28 Versión lista para prueba. Faltan ajustes igual
    Faltan ajustes del tipo de valores de limites random, variable sleemode en true, ver tema de eui, appkey, etc. En teoría debería al menos poder enviar datos al GW
2021-08-11 Actualización de pines y union con GW exitosa.
2021-08-15 Se agrega la parte de esquematico de PCB
    [Test1.kicad_pcb, Test1.sch]
2021-08-23 Este ya tiene el wake up por RTC o Interrupt
    Se le agrega el corte de panel
2021-08-25 Se agrega PCB Layout
    Falta rutear
    [Test1.sch]
2021-08-27 Cambios antes de comenzar a rutear
    Se modificaron algunas cosas en esquemático para comenzar a rutear.
    [Test1.kicad_pcb, Test1.sch]
2021-10-07 Avance hasta el dia de la fecha con placa soldada y enviando datos.
    [Test1-B_Cu.gbr, Test1-B_Mask.gbr, Test1-B_SilkS.gbr, Test1-Edge_Cuts.gbr, Test1-F_Cu.gbr, Test1-F_Mask.gbr, Test1-F_SilkS.gbr, Test1-job.gbrjob]
2021-10-07 Otro PCB con corrimiento de pines USB
    [Test2.kicad_pcb]
2021-10-14 Hasta acá se arreglaron los problemas de K
    Funciona todo, envía ok, tanto caudal como frecuencia y se despierta si hay un cable cortado. Calcula correctamente y se puede configurar por usb. Falta probar panel conectado y luego la batería.
    [Test1.kicad_pcb, Test1.sch]
2021-10-26 Se agregan cosas muy útiles
    Se agrega última versión del programa junto con cosas de intro a proy que me van a servir. A su vez se hicieron las mediciones correspondientes con fotos.
    [Análisis de Rentabilidad_Planillas de Cálculos LoRa.xlsx, Análisis de Rentabilidad_Planillas de Cálculos v2.xlsx, Análisis de Rentabilidad_Planillas de Cálculos v3.xlsx, Análisis de Rentabilidad_Planillas de Cálculos.xlsx, Consumo caudal.xlsx, Consumos Placa LoraWan Medidora Caudal.xlsx, Factibilidad Economica - Cálculos LoRa.xlsx, Factibilidad Economica - Cálculos.xlsx]
2021-10-28 Se agrega el archivo de ProjectLibre
    Inicio del diagrama de Gant
2021-10-28 Resumen de las mediciones
2021-11-09 Planillas de costos
    [Análisis de Rentabilidad_Planillas de Cálculos LoRa V2.xlsx, Factibilidad Economica - Cálculos LoRa con Bat 7Ah.xlsx, Factibilidad Economica - Cálculos LoRa con Soft y bat 7Ah.xlsx, Factibilidad Economica - Cálculos LoRa con Soft.xlsx, Listado Materiales Medidor Caudal LoRaWAN Lucho con bat 7Ah.xlsx, Listado Materiales Medidor Caudal LoRaWAN Lucho.xlsx, Modelo de costeo de proyecto - LoRa con Bat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]
2021-11-24 Asignación de Recursos y Nuevos datos para economiua
    [Factibilidad Economica - Cálculos LoRa con Bat 7Ah.xlsx]
2021-11-24 Nueva Asignación de recursos antes de reunión con tutor
    [Factibilidad Economica - Cálculos LoRa con Bat 7Ah.xlsx]
2021-11-28 Principio de costos + Flows
    [Listado Materiales Medidor Caudal LoRaWAN.xlsx]
2021-12-03 Avance en Costos y Grafana
    [Listado Materiales Medidor Caudal LoRaWAN.xlsx]
2021-12-04 Agregado de gastos postventa de 10 kits
    [Listado Materiales Medidor Caudal LoRaWAN.xlsx]
2021-12-07 Se cambiaron las torres metálicas por plásticas. Avance informe
    [Listado Materiales Medidor Caudal LoRaWAN.xlsx]
2021-12-11 Avance Proyecto
    [Listado Materiales Medidor Caudal LoRaWAN.xlsx]
2021-12-17 Avance con cierre de Fact Economica
    [Listado Materiales Medidor Caudal LoRaWAN.xlsx]
